wozniak-works/Internal-USB-Hub/docs/TPS25983_Design_Calculator_v1.4.xlsm

TPS25983 Design Calculation Tool
Constants Cells | Input/SelectCells | Calculation Cells |  |  | Recommended
Error Cells, Must be Fixed | Calculated, but can be over-ridden by user |  |  |  | Value
Parameter | Description | Value | Units | Tolerance
VIN (nom) | Nominal operating input voltage | 12.00 | V
VIN (max) | Maximum Operating input voltage (magnitude) | 14.40 | V |  | #REF!
OVLOset | Overvoltage Threshold (VIN Rising) | 15.00 | V
UVLOset | Undervoltage Threshold (VIN Rising) | 9.60 | V
VUVP | Internal IN Undervoltage Protection Threshold (VIN Rising) | 2.53 | V | 2.7%
Cout | Load Capacitance | 1000.0 | uF | 10.0%
Rlstart | Load at start-up (assumed to be resistive), Refer to Section 9.2.2.5.2 in Datasheet (http://www.ti.com/lit/ds/symlink/tps25982.pdf) | 24.0 | Ohm |  | 1.0
Imax | Maximum continuous load current (magnitude) | 12.50 | A
Ilimit | Set current Limit 20% (typical) higher than maximum continuous load current | 15.00 | A
TA(max) | Max Ambient Temperature | 70 | degC
 | Do you need to be immue to line transient due to adjacent card “hot-swap events” | No
tITIMER | Enter the time interval to support load transient currents | 2000 | us
 | Fault Response | Auto-Retry
tRETRY_DLY | Time delay between retries | 100.00 | ms
NRETRY | Number of retries | 4
Rec_VIMONMax | Recommended maximum IMON voltage | 3.3 | V
VIMON-Max | Enter current monitor (IMON) full-scale voltage range | 2.0 | V
UVLO, OVLO set point calculations |  |  |  |  |  |  |  |  |  | 960 |  | 71.28571429
UVLO Set Point | Desired Undervoltage Threshold (VIN Rising) | 9.60 |  |  |  |  |  | 8.66 | Power Fail (VIN Falling) | 150
OVLO Set Point | Desired Over Voltage Lockout Set Point | 15.00 |  |  |  |  |  | 9.44 | Release UVLO (VIN Rising)
R1: Pullup at EN/OVLO Pin | Value > 350K recommended | 499.0 | kOhm | 1.0% |  |  |  | 14.74 | OV Cut-off (VIN Rising) | 154
R2_cal | Calculated value of Resistor at EN/OVLO pin | 25.7 | kOhm
R3_cal | Calculated value of Resistor at EN/OVLO pin | 45.6 | kOhm
SELECT THE VALUE OF RESISTORS AS CLOSEST AVAILABLE VALUE OF R2 & R3
R2 | Select the closest possible value as R2_cal | 26.10 | kOhm | 1.00% | 26.1
R3 | Select the closest possible value as R3_cal | 46.53 | kOhm | 1.00% | 46.52906458
UV_final_rising | Undervoltage Threshold (VIN Rising) | 9.44 | V
UV_final_falling | Undervoltage Threshold (VIN Falling) | 8.66 | V
OV_final_rising | Overvoltage Threshold (VIN Rising) | 14.74 | V
OV_final_falling | Overvoltage Threshold (VIN Falling) | 13.51 | V
I_R123 | Current in R1, R2 and R3 Branch | 25.19 | uA
Calculations for Ilimit (resistor on ILIM Pin) |  |  |  |  |  |  |  | 0.56 | Inrush Charging Current | 256.6285714
RILIM_Cal | Calculated current limit resistor | 98.05 | Ohm |  |  |  |  | 14.71 | Overload Curr Limit | 261
SELECT A ILIMIT RESISTOR WITH THE CLOSEST AVAILABLE VALUE OF Rilim_Cal |  |  |  |  |  |  |  |  |  | 980.5238415
RILIM | Select the closest available value of RILIM_cal | 100 | Ohm | 1.0% | 100 |  |  |  |  | 1000
Ilimit_final | Final current Limit Set Point | 14.71 | A | 8.2% | 13.52 | A
Calculations for CURRENT MONITOR |  |  |  |  |  |  |  |  |  | 559.5141179
RIMON_max | Maximum allowed resistance at IMON pin | 559.51 | Ohm |  | 559.51 |  |  |  |  | 549
RIMON_sel | Resistor value selected at IMON pin | 549.00 | Ohm | 1.0% | 549
VIMON_final | Maximum voltage at IMON for maximum load current | 1.96 | V | 3.2%
The range of voltage output at IMON pin will be from 0V to VMON_imax |  | VIMON is Within Limits
Calculations for SoftStart control (external cap on dVdt pin)
Parameter | Description | Value | Units | Tolerance
Tchg_fastest | When no external capacitor is connected (max. slew rate) | 1.63 | ms | 15.0%
Icharge_fastest | Charging current when charging at fastest possible rate If this current is < Ilimit, no capacitor is required at dVdT pin | 7.35 | A
Tchg_req | The charging time required | 20.00 | ms
Icharge_req | Charging (inrush) current desired in the system | 1.00 | A
Cext_dvdt_cal1 | Calculated value of capacitor at dVdT pin for required Tcharge | 7.67 | nF
Cext_dvdt_cal2 | Calculated value of capacitor at dVdT pin for required Icharge | 4.60 | nF |  | 7.67
SELECT A CAPACITOR WITH THE CLOSEST POSSIBLE VALUE to max(Cext_dvdt_cal1, Cext_dvdt_cal2)
CdVdT_ext | The external capacitor connecetd across dVdT pin | 8.20 | nF | 10.0% | 8.2
Icharge | Charging Current as per dVdT setting | 0.56 | A | 18.0%
Does Device Enter Current Limit during start-up? |  | FALSE |  |  | 527.76
Tchg_dVdT | Charging time set | 21.39 | ms | 18.0%
Pd_Cout_startup | Power dissipation due to load cap at start-up | 3.37 | W
Total Power dissipation at Start-up
Pd_Rlstart | Power dissipation due to load resistance at start-up | 1.00 | W
Pd_startup | Total power dissipation at start-up | 4.37 | W |  |  |  |  |  |  | 9.41 | 9.28
 | Max power dissipation allowed for glitch-free startup for the programmed startup time (20% margin) | 7.53 | W | 20.0% | 9.41 |  |  |  |  | 6.40 | 6.69
 | Will the system have glitch-free startup? Look at Thermal Shutdown Limit Plot Tab | YES
Steady state Voltage drop & Power dissipation
Parameter | Description | Value | Units | Tolerance
Vdrop | Maximum voltage drop across device @ 25 degC | 40.00 | mV
Pdiss_Imax | Steady state power dissipation with Max current @ 25degC | 500.00 | mW
Calculations for Transient Overcurrent Blanking Interval
Citimer_cal | Calculated value of capacitor at ITIMER pin | 4.26 | nF |  | 4.26
Citimer_sel | Capacitor value selected at ITIMER pin | 4.30 | nF | 10.0% | 4.3
tITIMER_final | Time duration for which load transients between Ilimit and 2.1xIlimit are allowed | 2021 | us |  | 569.1734912 | nF
Setting the Auto-Retry Delay and Number of Retries
CRETRY_DLY_cal | Calculated value of capacitor at RETRY_DLY pin | 2.13 | nF |  | 2.13
CRETRY_DLY_sel | Capacitor value selected at RETRY_DLY pin | 2.20 | nF | 10.0% | 2.2
tRETRY_DLY_final | Time delay between retries | 103.21 | ms
CNRETRY_cal | Calculated value of capacitor at NRETRY pin | 2.20 | nF |  | 1.98
CNRETRY_sel | Capacitor value selected at NRETRY pin | 1.8 | nF | 10.0% | 1.8 | 3.266787659
NRETRY_final | Number of retries | 4 |  |  | 3.266787659 | 4
Design Summary
 |  | R1 = | 9.6 | kOhm | Parameter |  | Typical | Units
 |  | R2 = | 26.1 | kOhm | Current limit |  | 14.71 | A
 |  | R3 = | 46.53 | kOhm | Upper UVLO Threshold |  | 9.44 | V
 |  | RG = | 2 | Ohm | Lower UVLO Threshold |  | 8.66 | V
 |  | RILIM = | 100 | Ohm | Output voltage ramp time, TdVdt |  | 21.39 | ms
 |  | RIMON = | 549 | Ohm
 |  | RPG = | 10.00 | kOhm | Transient overcurrent blanking interval (tITIMER) |  | 2021 | us
 |  | CdVdt = | 8.20 | nF
 |  | CITIMER = | 4.3 | nF | Time delay between retries |  | 103.21332 | ms
 |  | CRETRY_DLY = | 2.2 | nF | Number of retries |  | 4
 |  | CNRETRY = | 1.8 | nF
 |  |  |  |  | Overvoltage lockout |  | 14.74 | V
Notes: | 1. Although not mandatory, CIN provides transient suppression at the VIN pin | CIN = | 0.01uF | uF
 | 2. TVS clamp diode D1 from VIN to GND is recommented to clamp the voltage overshoot during device turn-off, e.g. during circuit breaker | COUT = | Optional
 | 3. Schottky diode D2 from VOUT to GND is mandatory to absorb negative spikes | D1 = | SMCJxx
 |  | D2 = | B530C-13-F
Parameters internal to Device
Internal FET Parameters
Parameter | Description | Value | Units | Tolerance
VDSS (max) | FET drain-source voltage rating (maximum) | 30.0 | V
ID(max) | FET drain-source current rating (maximum) | 18.0 | A
Rds(on) | FET maximum Rds(on) at 25degC | 3.20 | mOhm
Rds(on)_max | FET maximum Rds(on) at 125degC | 4.50 | mOhm
Thermal Parameters
Tj(max) | Device maximum junction temperature | 150.0 | C
TA(max) | Maximum ambient temperature of the application | 125.0 | C
RJC(top) | Junction to case (top) Thermal Resistance | 36.7 | C/W
RJA | Junction to ambient thermal resistance | 34.6 | C/W
RJC(bot) | Junction-to-case(bottom) thermal resistance | 1.6 | C/W
Internal References
Uvref_rise | Internal Undervoltage reference (Rising) | 1.20 | V | 2.5%
Uvref_fall | Internal Undervoltage reference (Falling) | 1.10 | V | 2.7%
GainIMON | Current monitor gain | 243.00 | uA/A | 3.0%
Idvdt | dVdt Pin Charging Current | 4.76 | uA | 3.0%
Delay
tD,ON | Device turn ON delay | 3.29 | ms
tGHI | Time taken to reach steady state | 30.17 | ms
