wozniak-works/Internal-USB-Hub/production/Impedance-matching/Screenshot 2026-03-18 173056.png

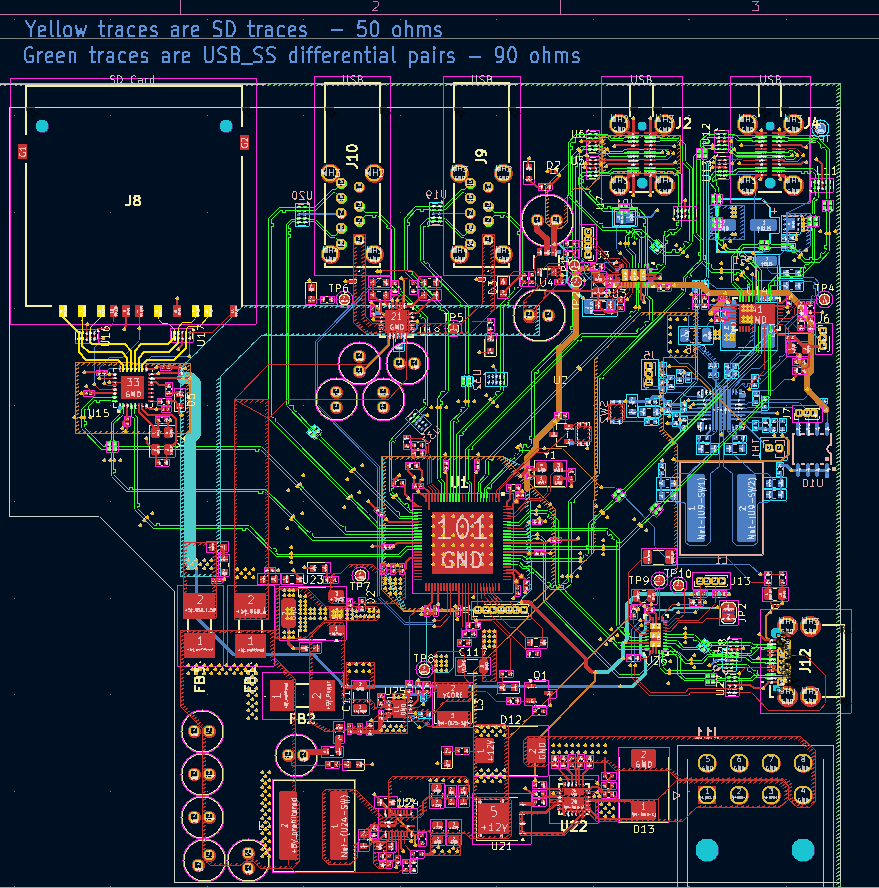
production/Impedance-matching/Screenshot 2026-03-18 173056.png
