wozniak-works/Internal-USB-Hub/production/Impedance-matching/Screenshot 2026-03-18 173109.png

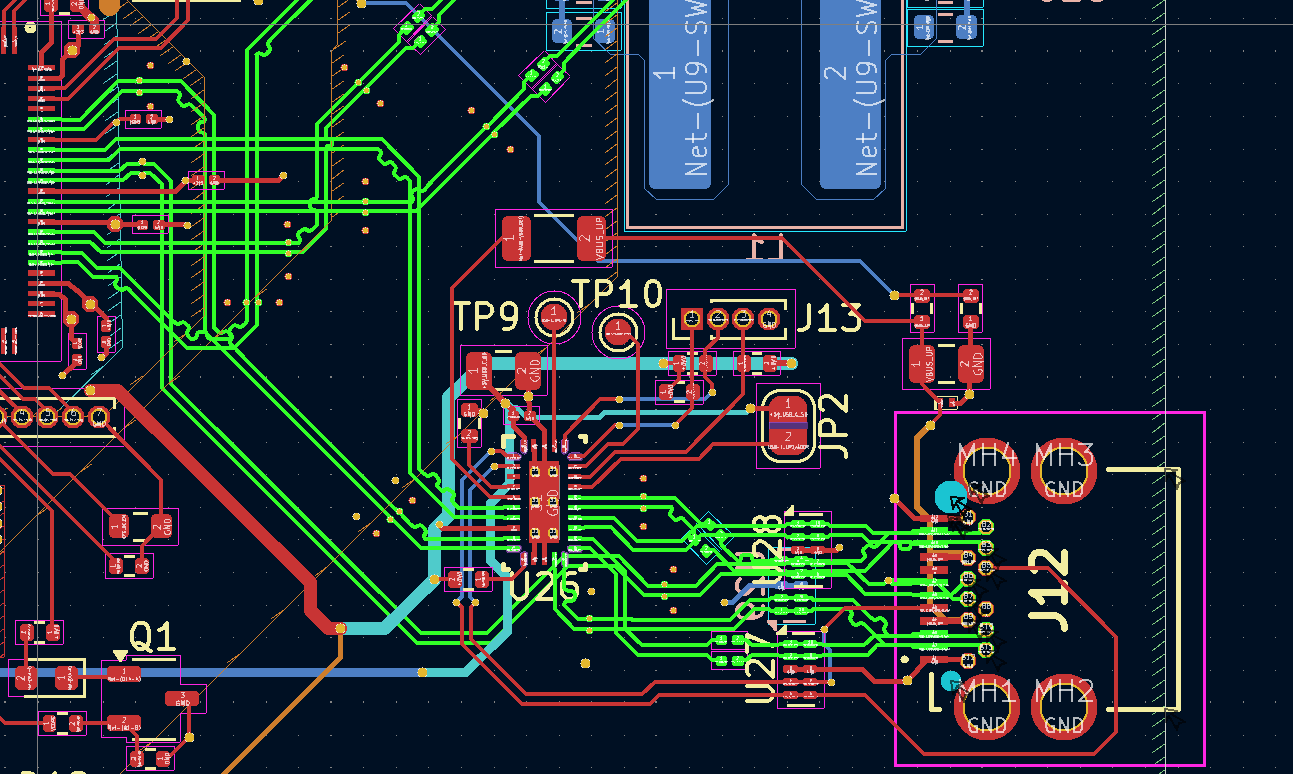
production/Impedance-matching/Screenshot 2026-03-18 173109.png
