wozniak-works/Internal-USB-Hub/footprints/TVS2200DRVR/TVS2200DRVR.step

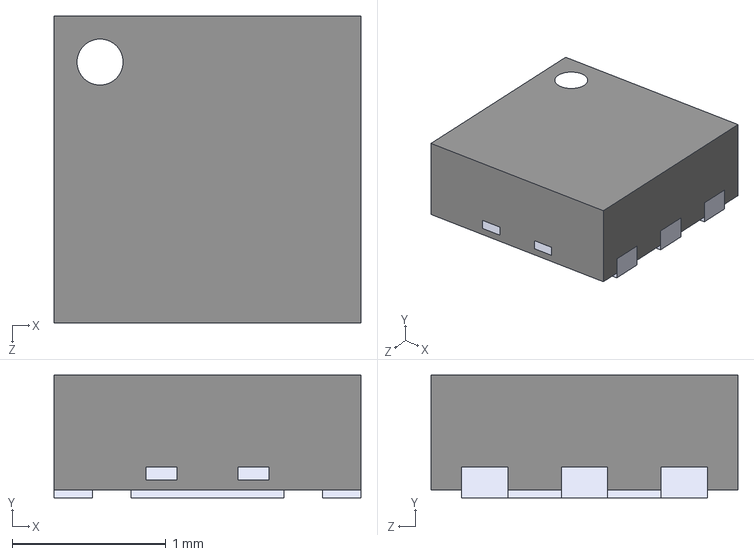
[picture p7: CAD file, 2026-03-18]
footprints/TVS2200DRVR/TVS2200DRVR.step
2.00 x 0.8 x 2.00 mm
