wozniak-works/Internal-USB-Hub/footprints/ul_HD3SS3220IRNHR/RNH0030A.stp

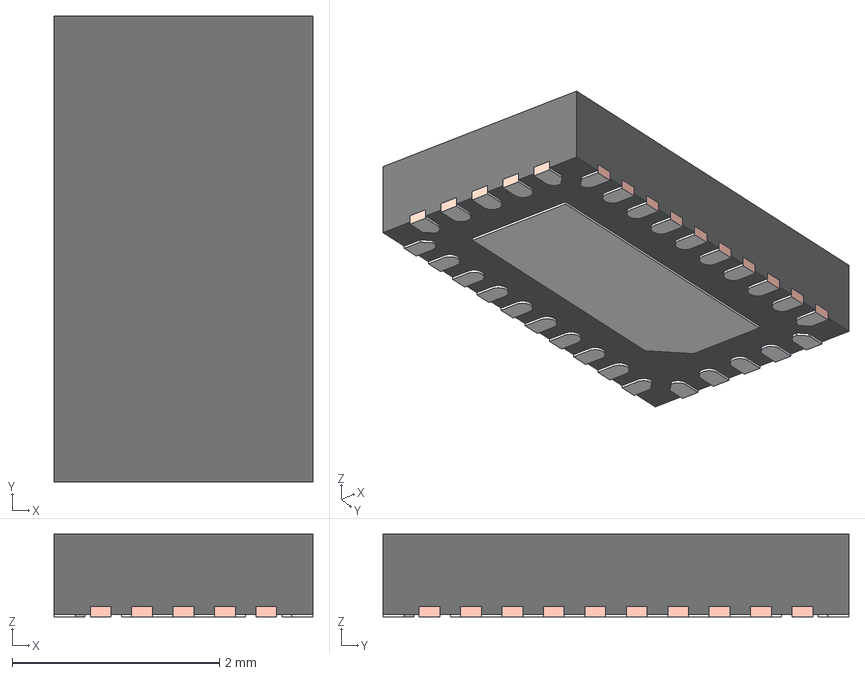
[picture p8: CAD file, 2026-03-18]
footprints/ul_HD3SS3220IRNHR/RNH0030A.stp
2.50 x 4.50 x 0.8 mm
BODY-QFN
FRAME-RNH0030A
PIN1-ID
