wozniak-works/Internal-USB-Hub/footprints/ul_TUSB1146IRNQR/RNQ0040A.stp

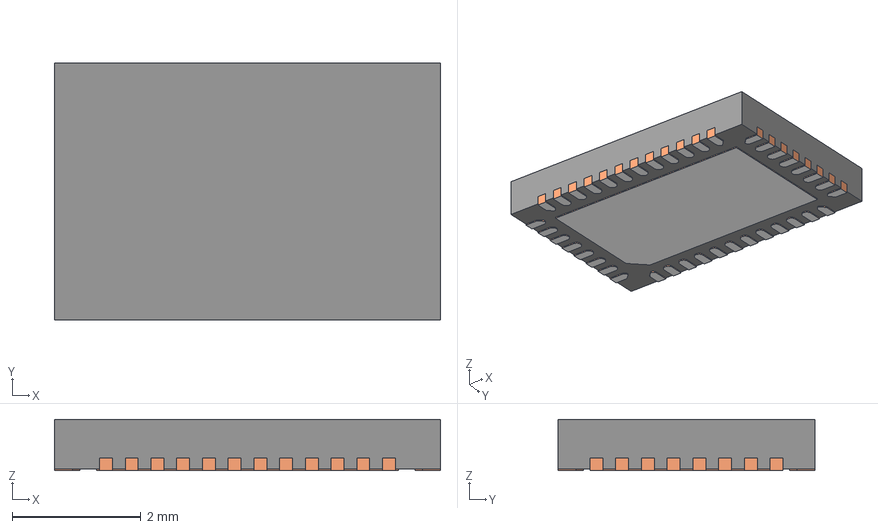
[picture p9: CAD file, 2026-03-18]
footprints/ul_TUSB1146IRNQR/RNQ0040A.stp
6.00 x 4.00 x 0.8 mm
BODY-QFN
FRAME-RNQ0040A
PIN1-ID
