wozniak-works/Internal-USB-Hub/footprints/ul_USB7206C-KDX/VQFN100_KDX_MCH.step

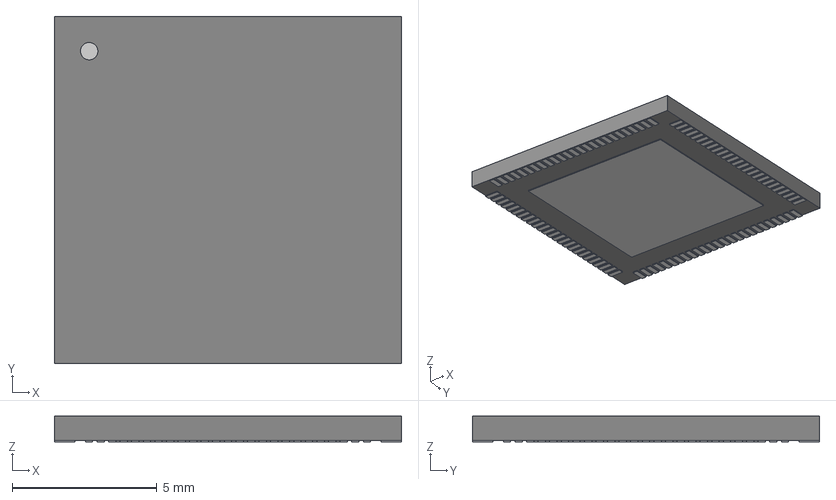
[picture p10: CAD file, 2026-03-18]
footprints/ul_USB7206C-KDX/VQFN100_KDX_MCH.step
12.0 x 12.0 x 0.892 mm
