wozniak-works/Internal-USB-Hub/footprints/TPS25750DRJKR/TPS25750DRJKR.step

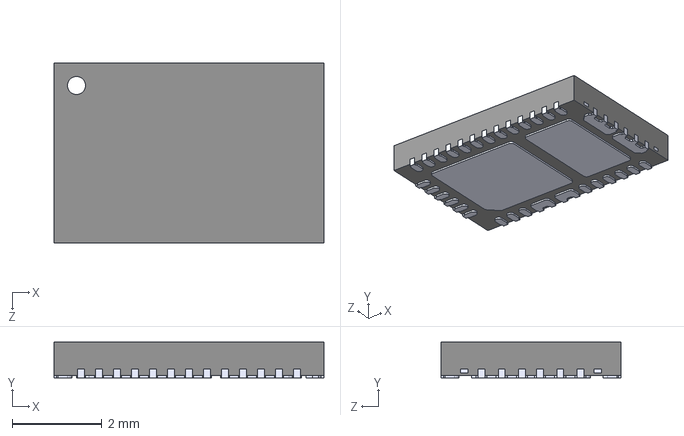
[picture p11: CAD file, 2026-03-18]
footprints/TPS25750DRJKR/TPS25750DRJKR.step
6.00 x 0.8 x 4.00 mm
