wozniak-works/Internal-USB-Hub/(list of files, cad)

Other CAD files:
footprints/ul_HD3SS3220IRNHR/RNH0030A.stl
footprints/ul_TUSB1146IRNQR/RNQ0040A.stl
footprints/ul_USB7206C-KDX/VQFN100_KDX_MCH.stl
