wozniak-works/Internal-USB-Hub/USB_hub.pdf

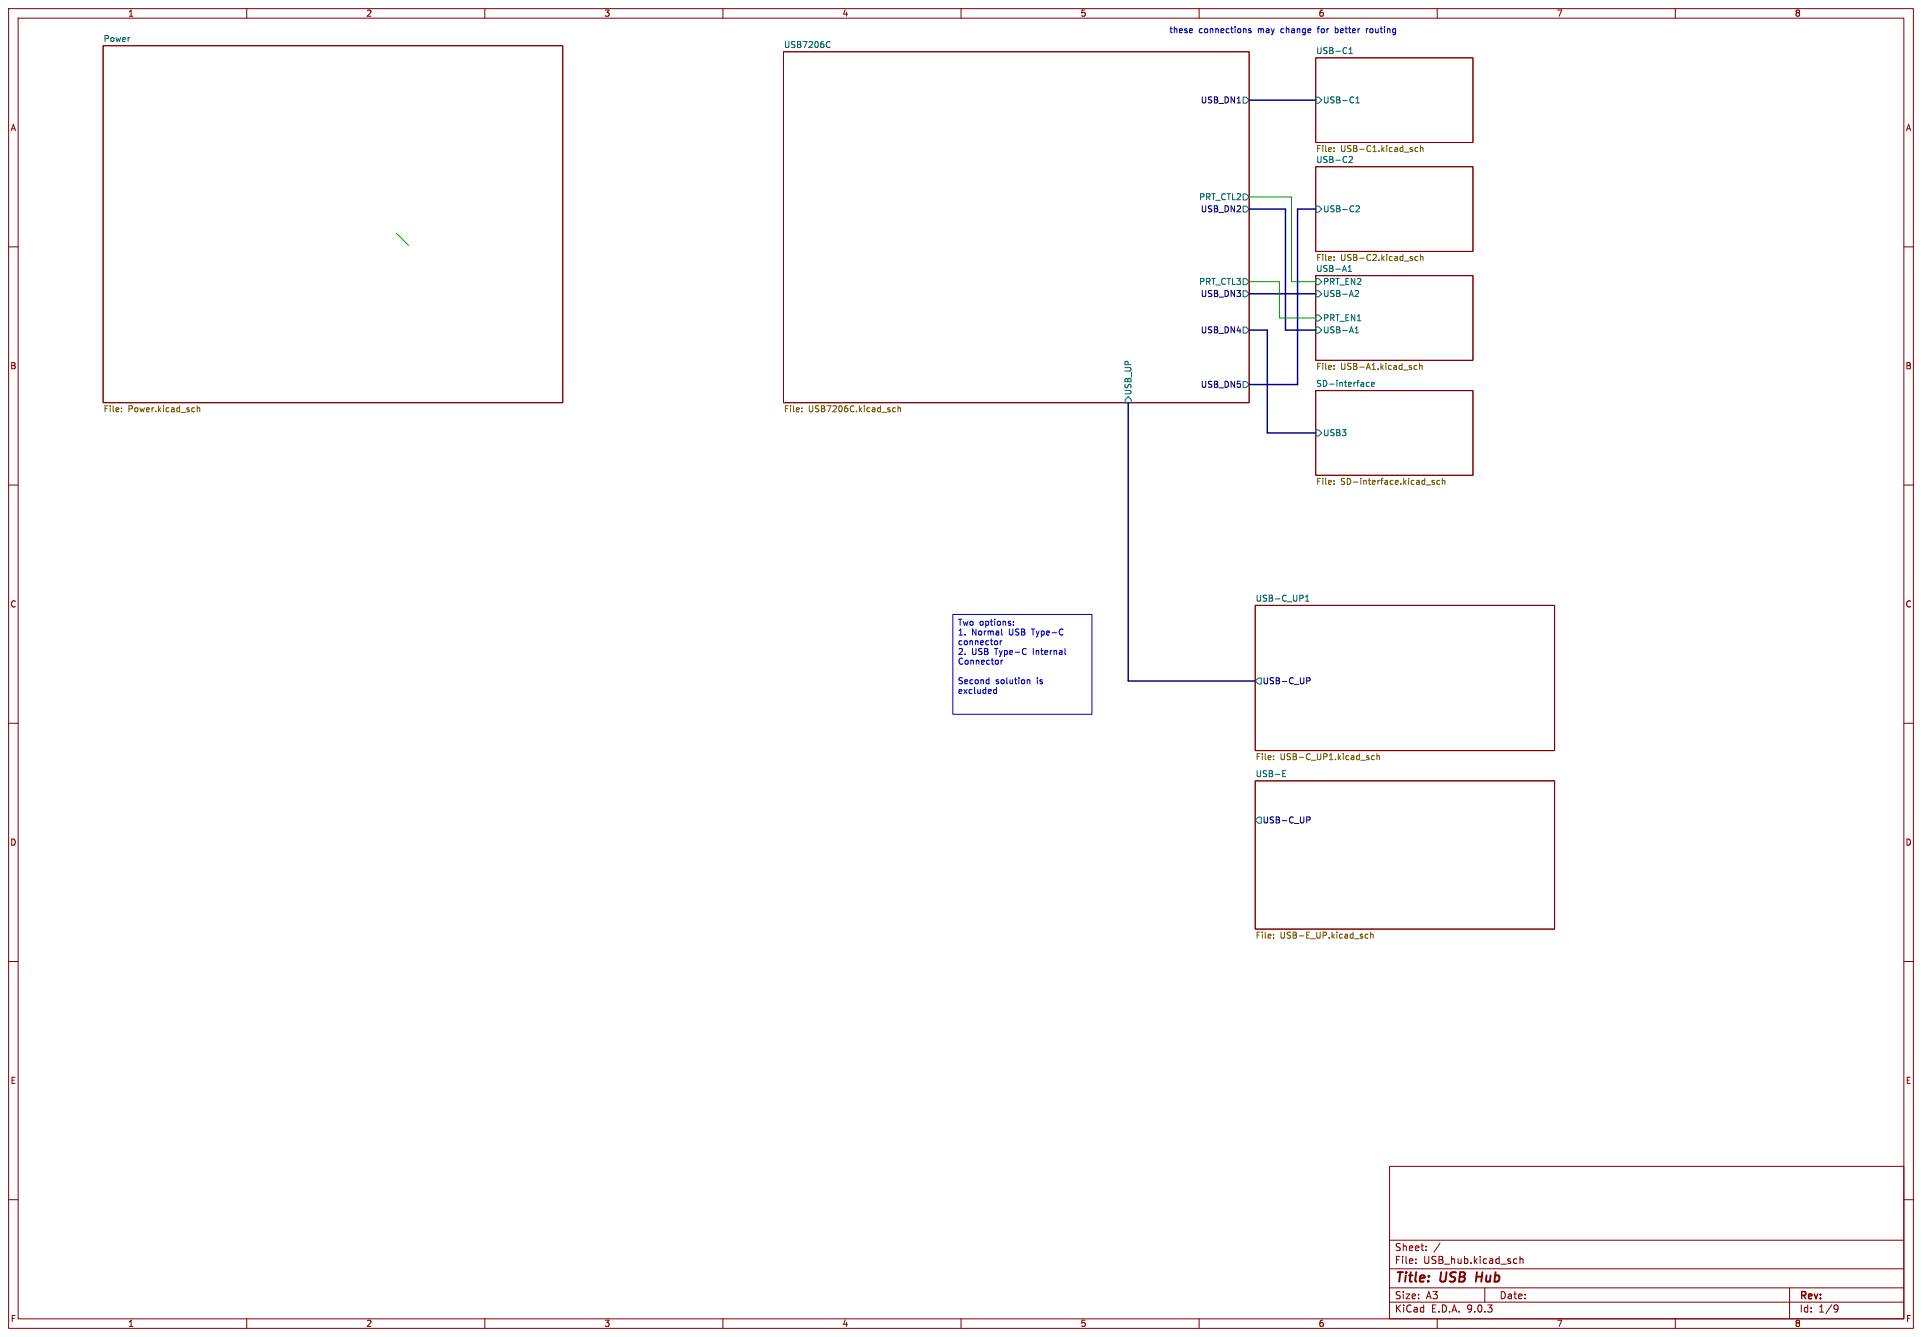
[picture p12: page 1]

File: USB-E_UP.kicad_sch Two options: 1. Normal USB Type-C

File: USB_hub.kicad_sch Sheet: /
Id: 1/9 Title: USB Hub

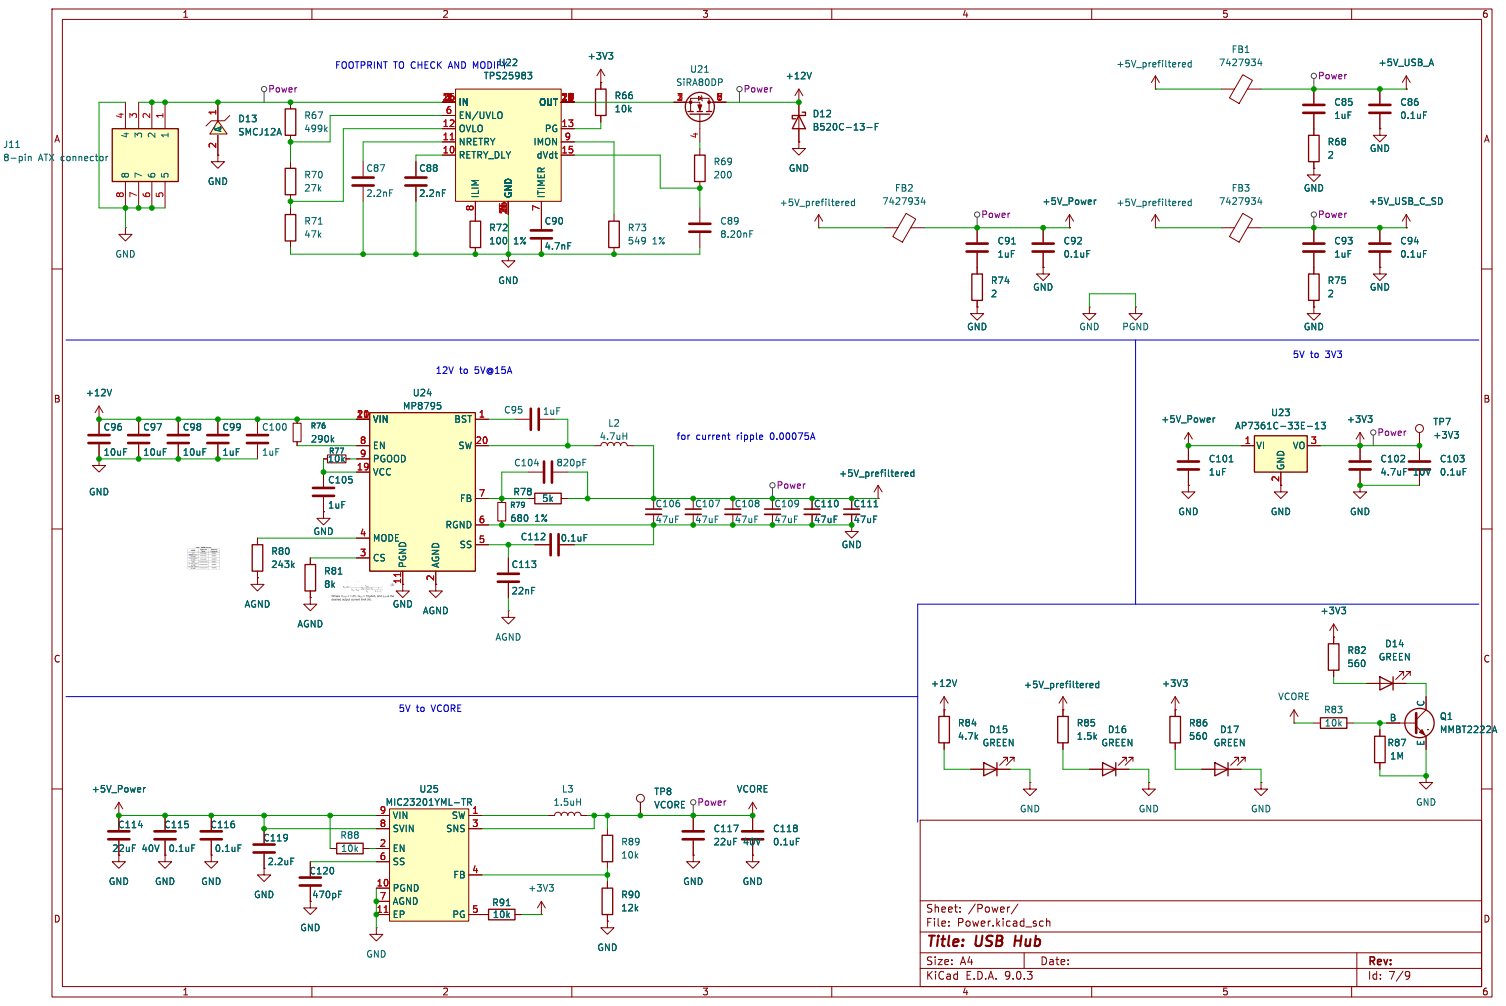
[picture p13: page 2]

FOOTPRINT TO CHECK AND MODIFY

2 BST 1 SW 20 FB 7 RGND 6 SS 5 GND

2 BST 1 SW 20 FB 7 RGND 6 SS 5 U24 MP8795 C113

File: Power.kicad_sch Sheet: /Power/ R91

Id: 7/9 Title: USB Hub

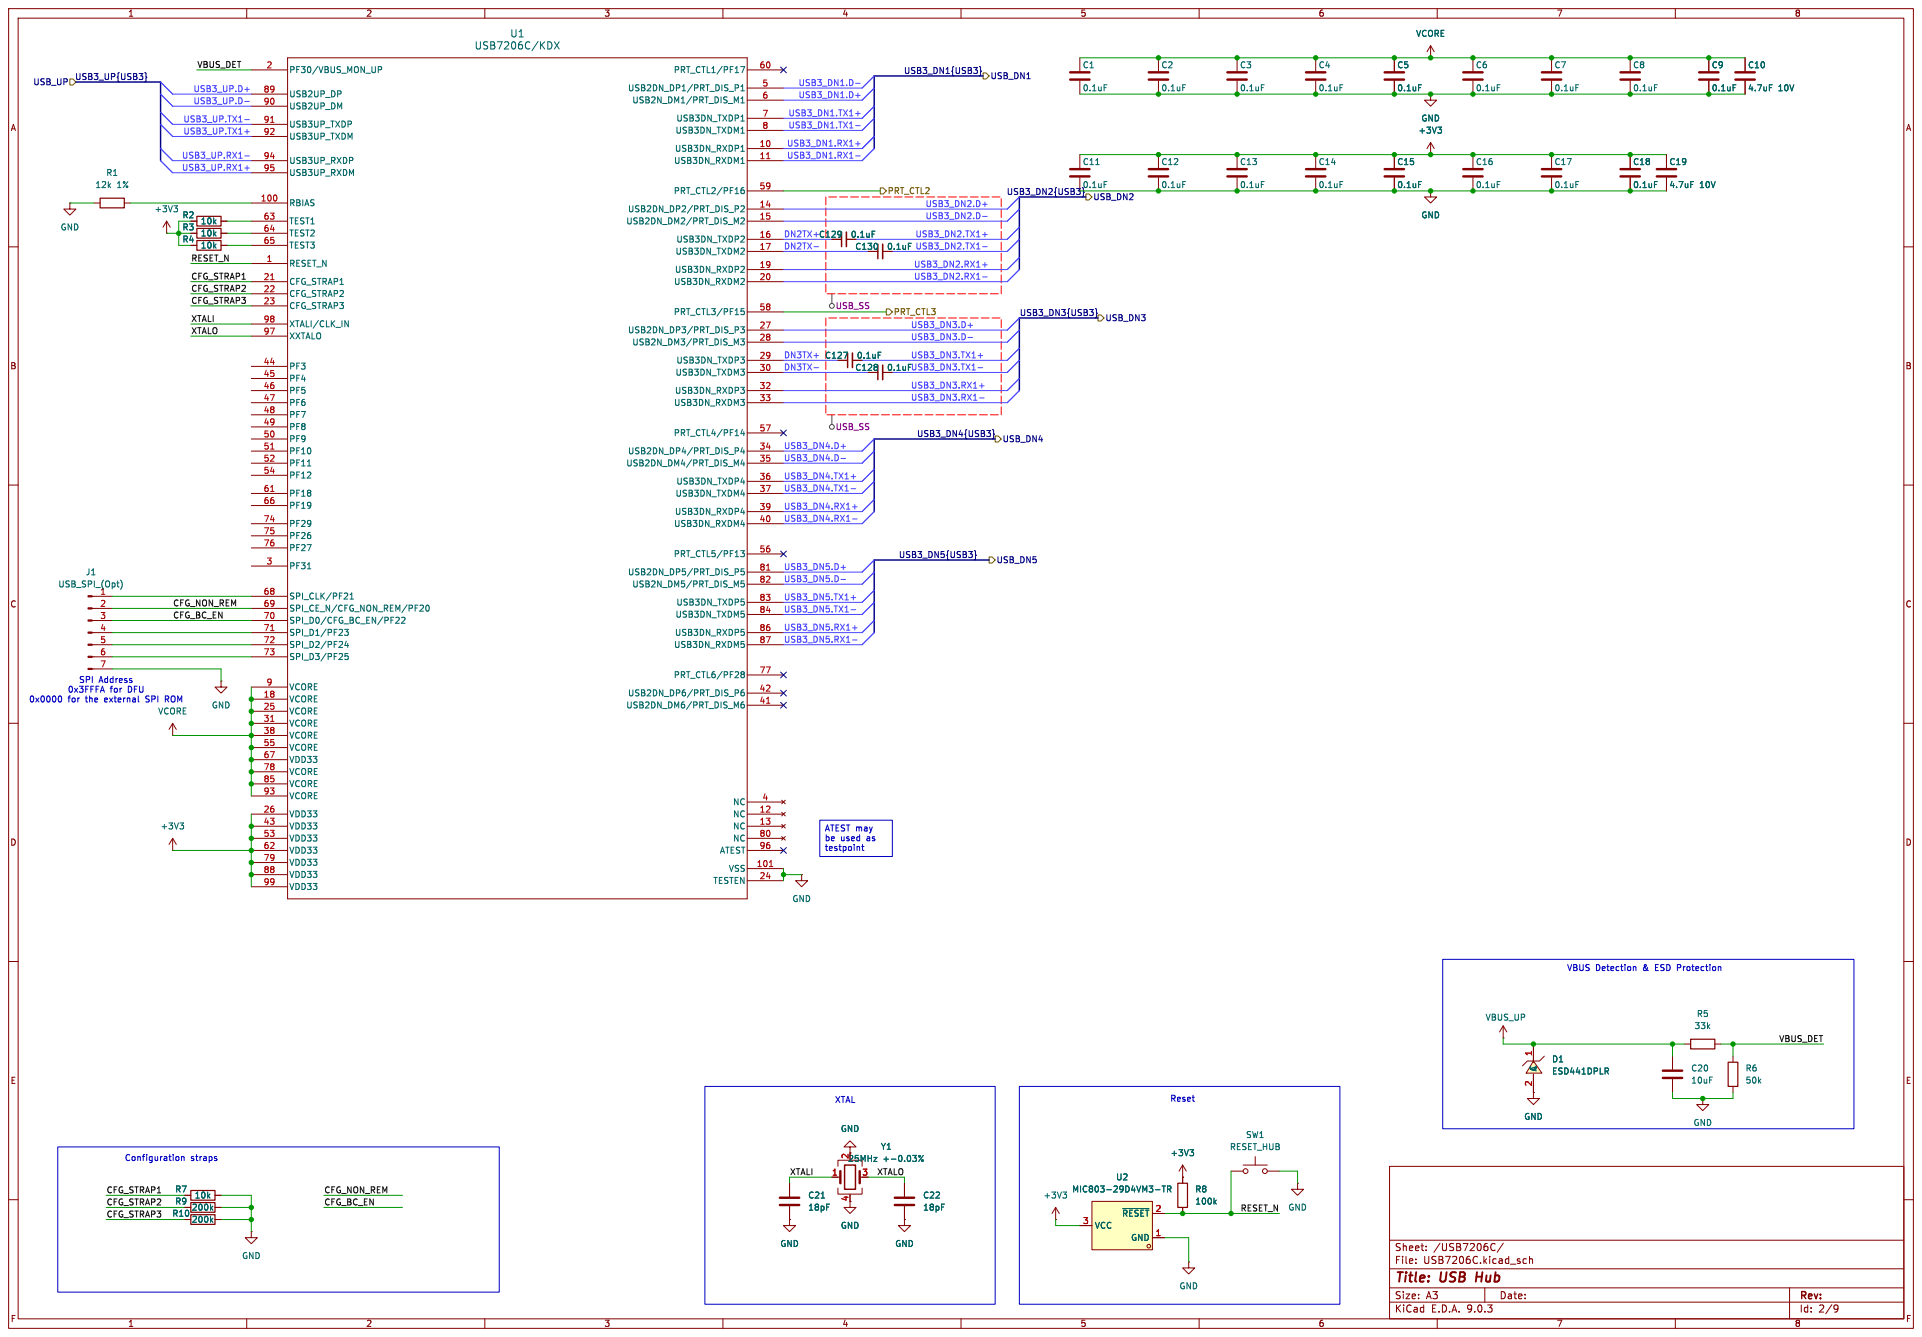
[picture p14: page 3]

ATEST may be used as

Id: 2/9 Title: USB Hub

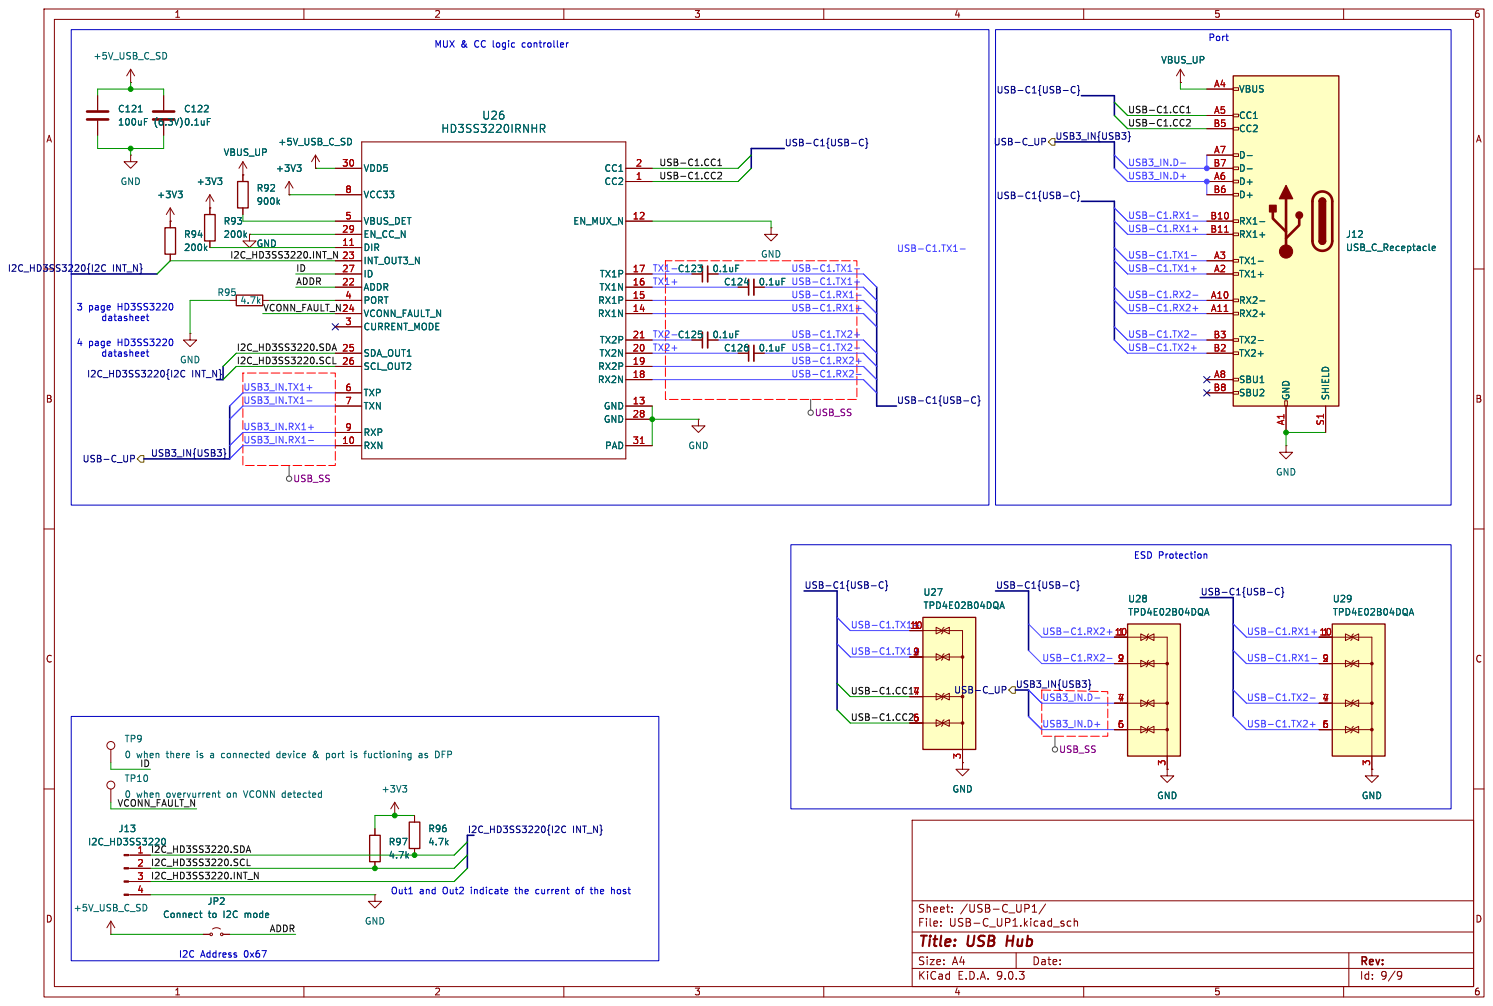
[picture p15: page 4]

Id: 9/9 Title: USB Hub

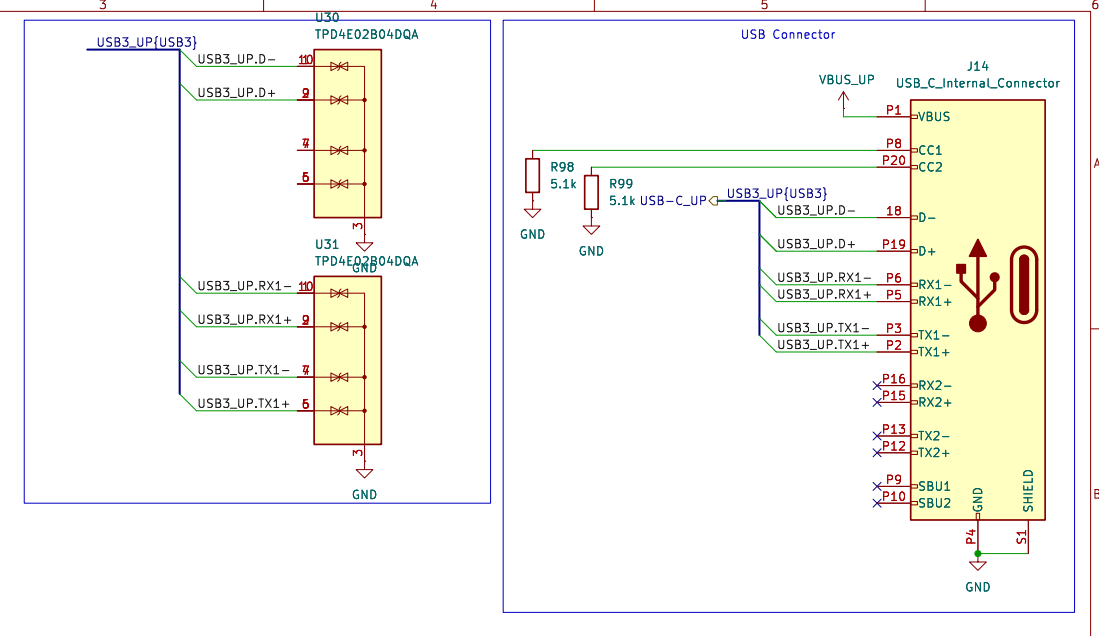
[picture p16: page 5]

File: USB-E_UP.kicad_sch Sheet: /USB-E/
Id: 10/9 Title: USB Hub

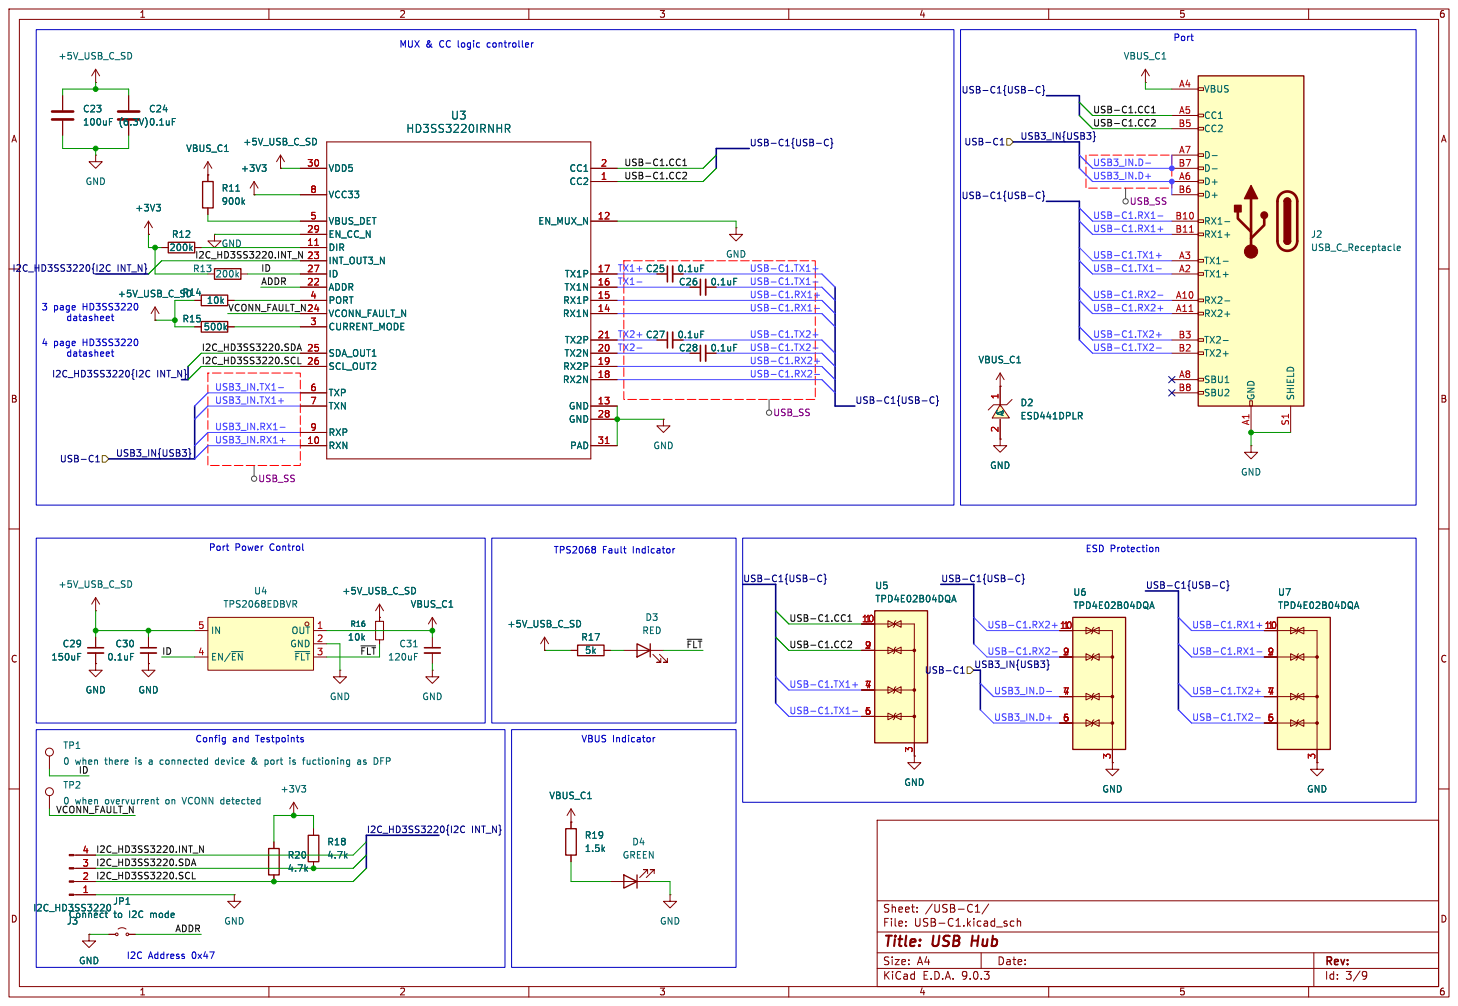
[picture p17: page 6]

USB-C1.CC1 USB-C1.CC2 USB-C1{USB-C}

Id: 3/9 Title: USB Hub

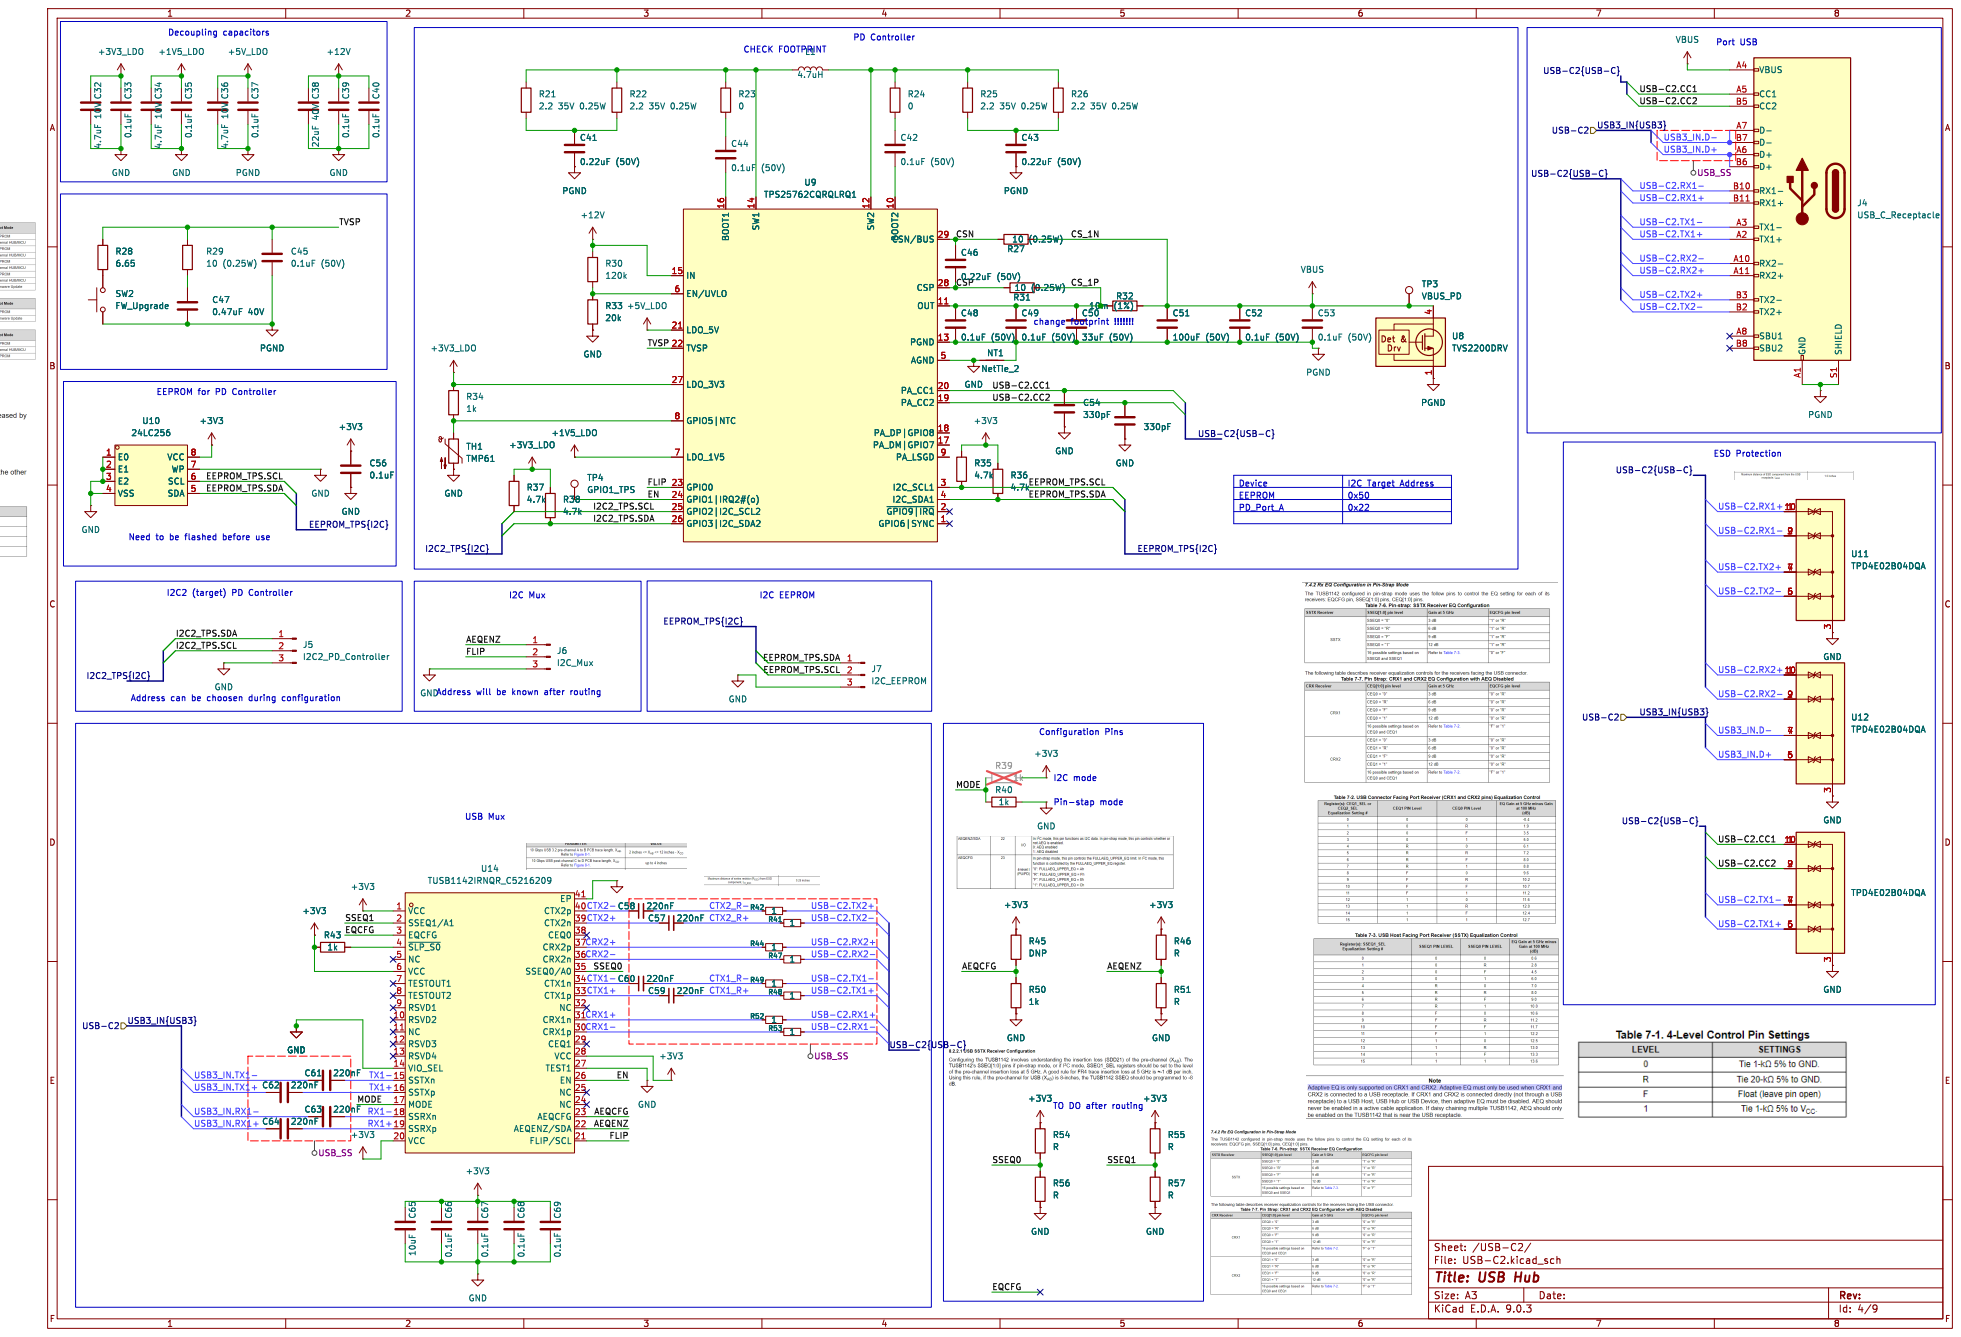
[picture p18: page 7]

CHECK FOOTPRINT Need to be flashed before use

VBUS
PGND SHIELD S1 GND A1 VBUS

USB-C2.TX1- USB-C2.RX2+ USB-C2.RX2- USB-C2.TX1+

Address can be choosen during configuration

File: USB-C2.kicad_sch Sheet: /USB-C2/ R57 R

Id: 4/9 Title: USB Hub

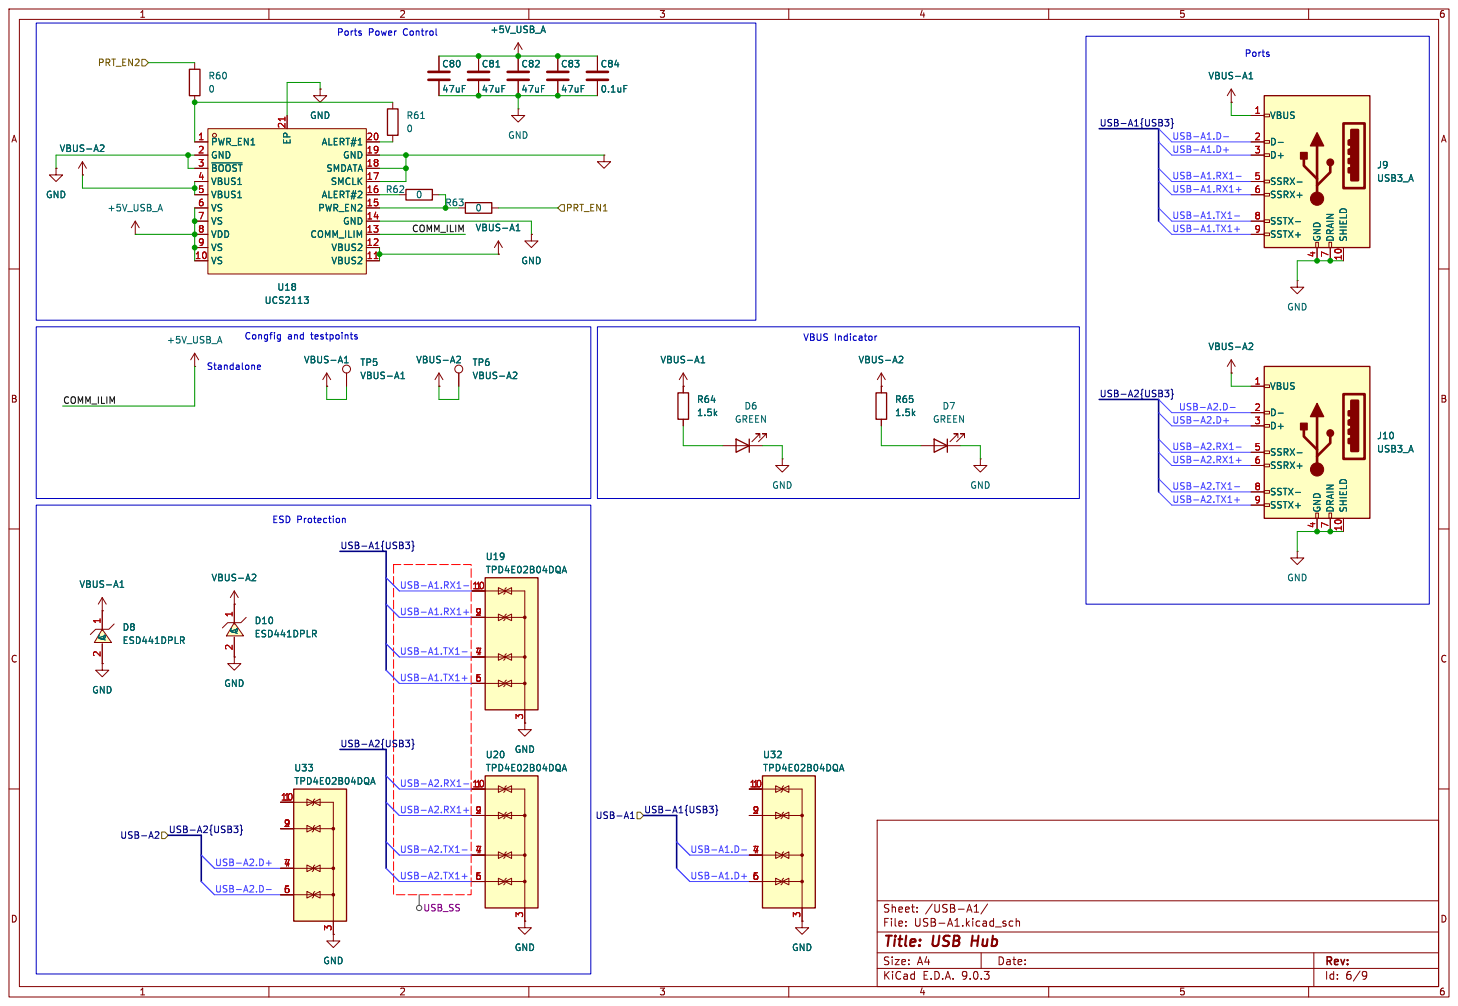
[picture p19: page 8]

4 VBUS 1 D- 2 D+ 3 SSRX- 5 SSRX+ 6 SSTX- 8 SSTX+ 9

4 VBUS 1 D- 2 D+ 3 SSRX- 5 SSRX+ 6 SSTX- 8 SSTX+ 9 VBUS-A2 TP6 VBUS-A2 TP5 VBUS-A2 VBUS-A1 VBUS-A1R64

File: USB-A1.kicad_sch Sheet: /USB-A1/GND

Id: 6/9 Title: USB Hub

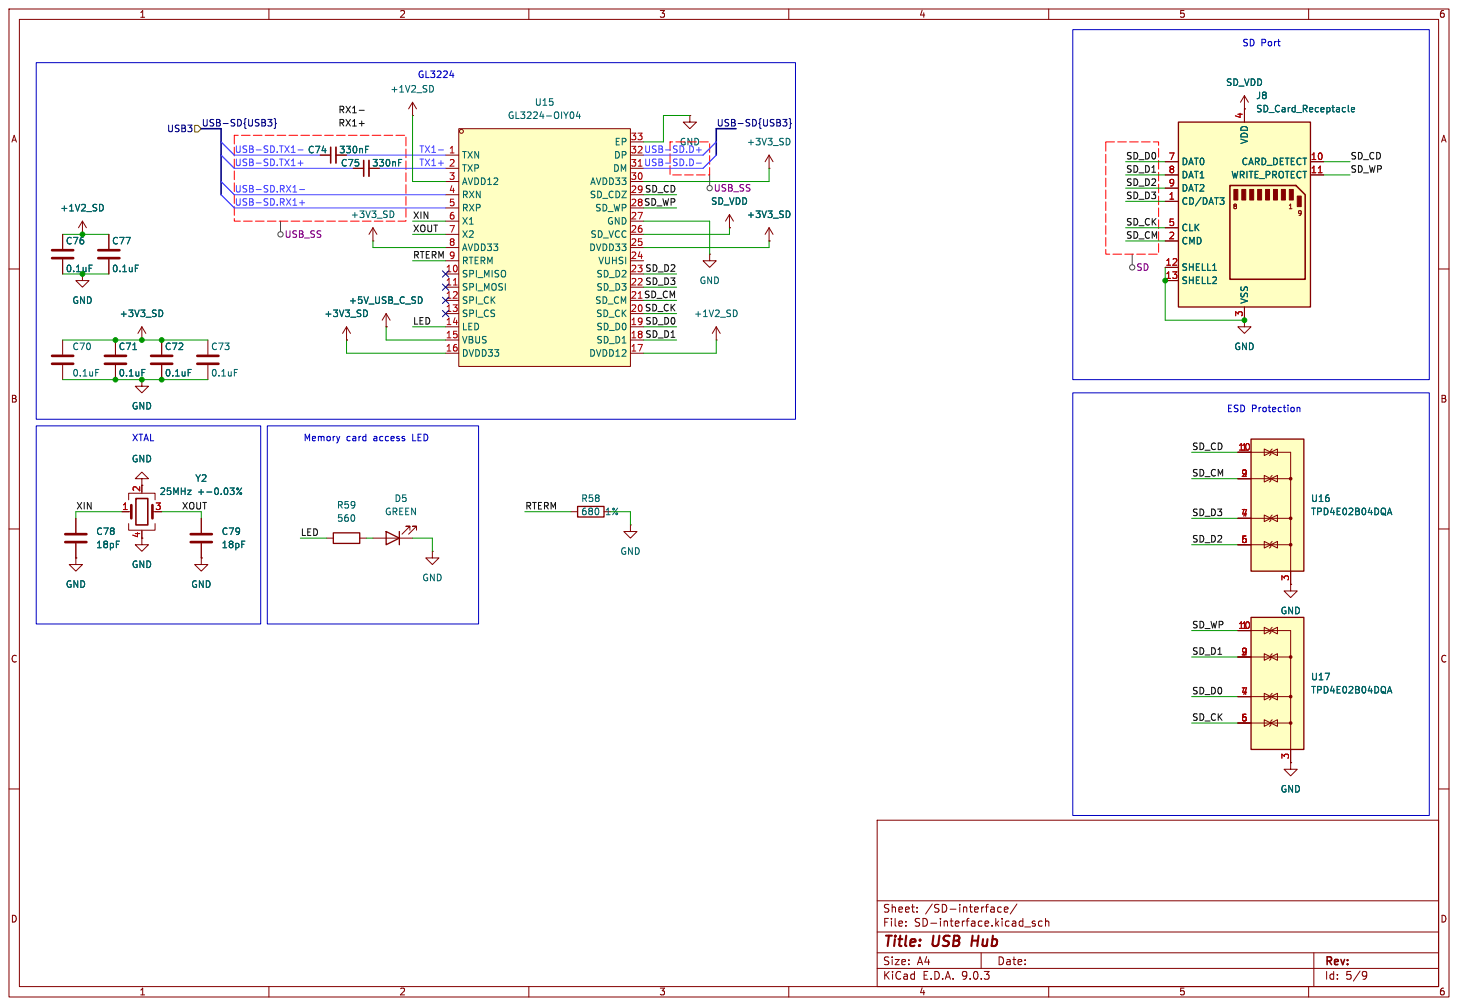
[picture p20: page 9]

SD_D1 SD_D2 SD_CK USB-SD.D+ USB-SD.D- SD_WP

File: SD-interface.kicad_sch Sheet: /SD-interface/
Id: 5/9 Title: USB Hub
