wozniak-works/Internal-USB-Hub/(list of files, drawings)

Other design files:
docs/application notes/3p3V_SAM9X6_SDRAM_MIC23201-Altium/MIC23201 Atmel Support.PrjPcb
docs/application notes/3p3V_SAM9X6_SDRAM_MIC23201-Altium/SCH/B_Microchip.SchDoc
