wozniak-works/Internal-USB-Hub/USB_hub.kicad_pcb

## KiCad design USB_hub.kicad_pcb (2026-03-18)

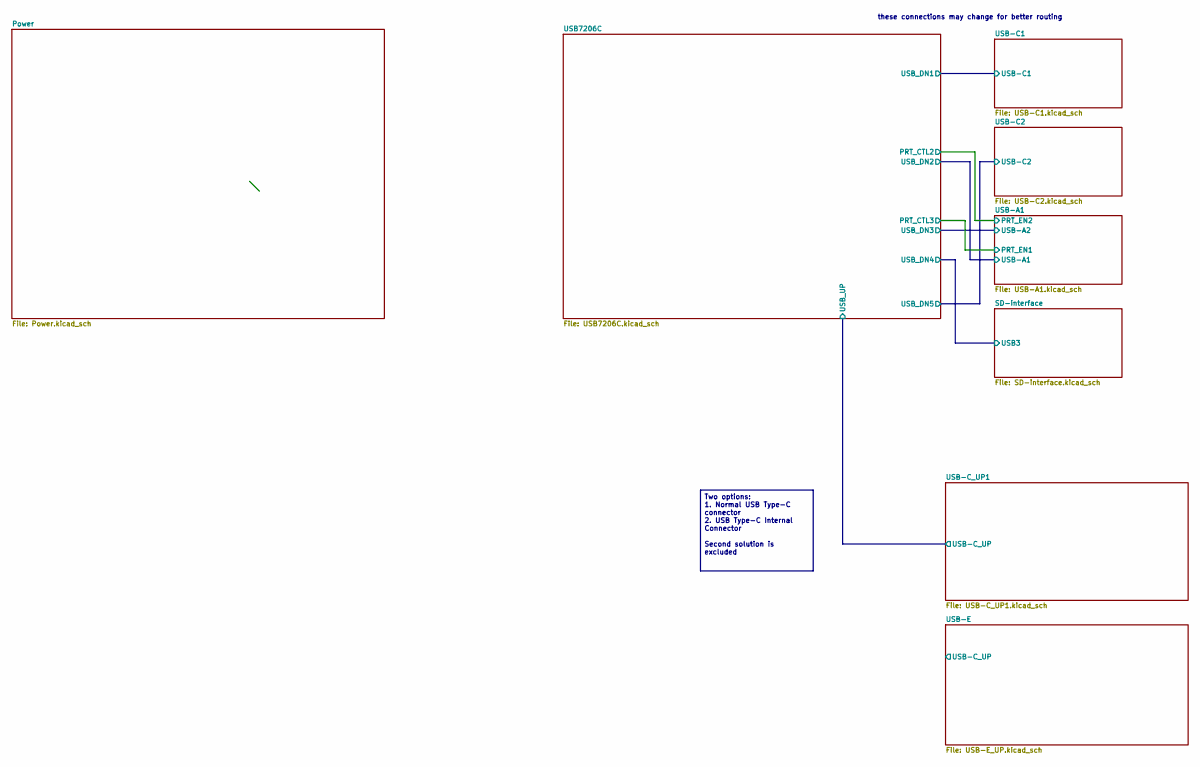
[picture p21: schematic USB_hub.kicad_sch, USB Hub]

Notes on the sheet:
these connections may change for better routing
Two options: 1. Normal USB Type-C connector 2. USB Type-C Internal Connector Second solution is excluded

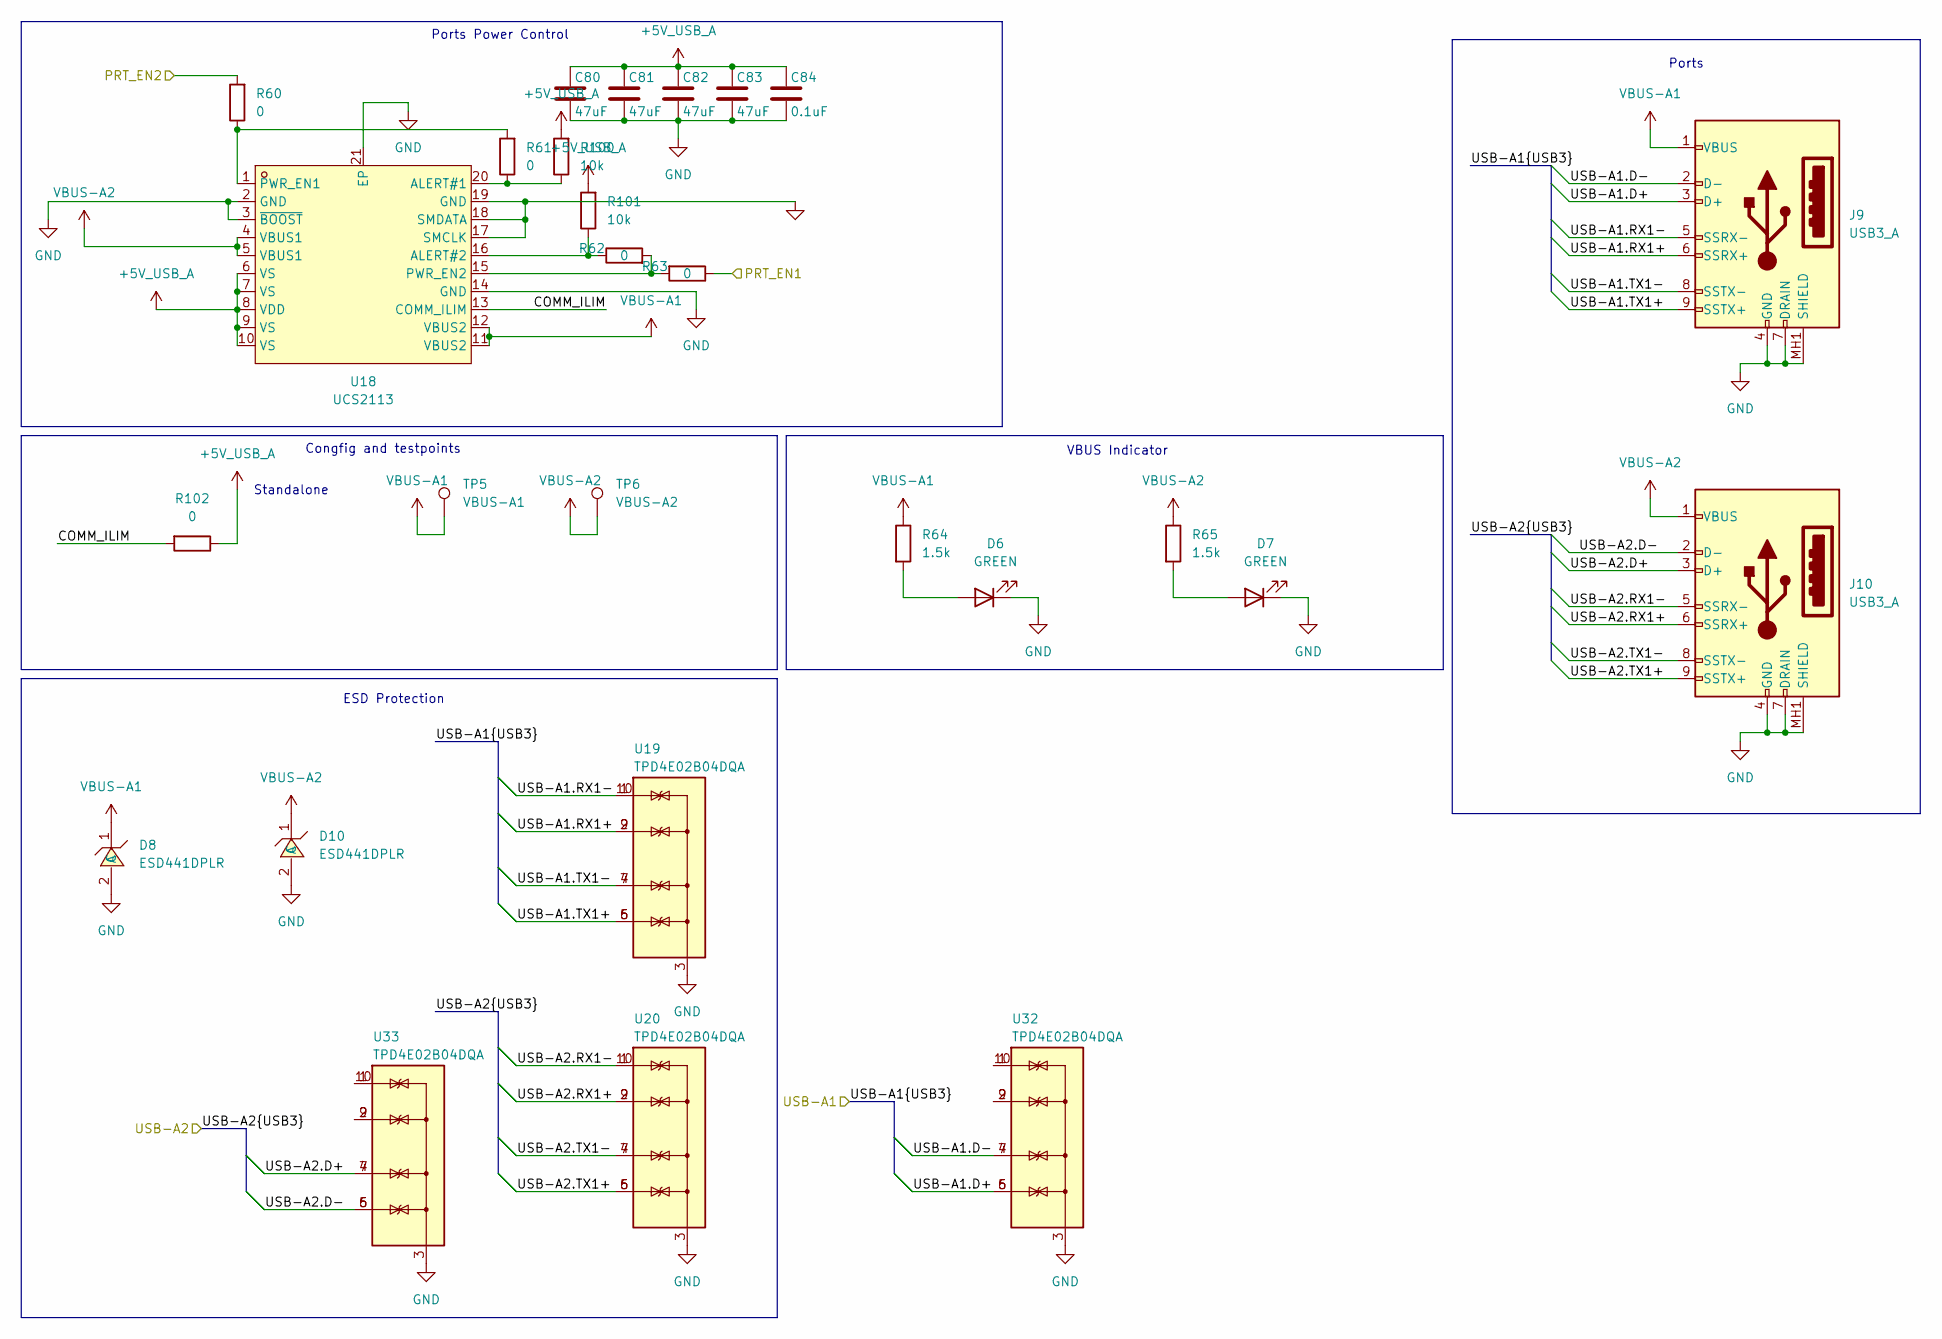
[picture p22: schematic USB-A1.kicad_sch, USB Hub]

Parts:
C80, C81, C82, C83: 47uF; C_Radial_D5.0mm_H11.0mm_P2.00mm; LCSC Part C721300
C84: 0.1uF; C_0201_0603Metric; LCSC Part C181043
D6, D7: GREEN; LED_0603_1608Metric; LCSC Part C22371298
D8, D10: ESD441DPLR; X2SON-2_L0.6-W0.3-P0.35; LCSC Part C22427765
J9, J10: USB3_A; GSB4116344HR; LCSC Part C5429469
R60, R61, R62, R63, R102: 0; R_0603_1608Metric; LCSC Part C2906974
R64, R65: 1.5k; R_0402_1005Metric; LCSC Part C327253
R100, R101: 10k; R_0402_1005Metric; LCSC Part C2906974
TP5: VBUS-A1; TestPoint_Pad_D1.0mm
TP6: VBUS-A2; TestPoint_Pad_D1.0mm
U18: UCS2113; QFN-20_L4.0-W4.0-P0.50-BL-EP2.7; LCSC Part C638222
U19, U20, U32, U33: TPD4E02B04DQA; USON-10_2.5x1.0mm_P0.5mm; LCSC Part C106794

Connections:
+5V_USB_A: C80.1, C81.1, C82.1, C83.1, C84.1, R100.2, R101.2, R102.1, U18.6 (VS), U18.7 (VS), U18.8 (VDD), U18.9 (VS), U18.10 (VS); also elsewhere on the board
/USB-A1/COMM_ILIM: R102.2, U18.13 (COMM_ILIM)
/USB-A1/PRT_EN1: R63.1; also elsewhere on the board
/USB-A1/PRT_EN2: R60.2; also elsewhere on the board
/USB-A1/USB-A1.D+: J9.3 (D+), U32.5 (IO4), U32.6 (NC); also elsewhere on the board
/USB-A1/USB-A1.D-: J9.2 (D-), U32.4 (IO3), U32.7 (NC); also elsewhere on the board
/USB-A1/USB-A1.RX1+: J9.6 (SSRX+), U19.2 (IO2), U19.9 (NC); also elsewhere on the board
/USB-A1/USB-A1.RX1-: J9.5 (SSRX-), U19.1 (IO1), U19.10 (NC); also elsewhere on the board
/USB-A1/USB-A1.TX1+: J9.9 (SSTX+), U19.5 (IO4), U19.6 (NC); also elsewhere on the board
/USB-A1/USB-A1.TX1-: J9.8 (SSTX-), U19.4 (IO3), U19.7 (NC); also elsewhere on the board
/USB-A1/USB-A2.D+: J10.3 (D+), U33.4 (IO3), U33.7 (NC); also elsewhere on the board
/USB-A1/USB-A2.D-: J10.2 (D-), U33.5 (IO4), U33.6 (NC); also elsewhere on the board
/USB-A1/USB-A2.RX1+: J10.6 (SSRX+), U20.2 (IO2), U20.9 (NC); also elsewhere on the board
/USB-A1/USB-A2.RX1-: J10.5 (SSRX-), U20.1 (IO1), U20.10 (NC); also elsewhere on the board
/USB-A1/USB-A2.TX1+: J10.9 (SSTX+), U20.5 (IO4), U20.6 (NC); also elsewhere on the board
/USB-A1/USB-A2.TX1-: J10.8 (SSTX-), U20.4 (IO3), U20.7 (NC); also elsewhere on the board
GND: C80.2, C81.2, C82.2, C83.2, C84.2, D6.1 (K), D7.1 (K), D8.2 (A), D10.2 (A), J9.4 (GND), J9.7 (DRAIN), J9.MH1 (SHIELD), J9.MH2 (SHIELD), J9.MH3 (SHIELD), J9.MH4 (SHIELD), J10.4 (GND), J10.7 (DRAIN), J10.MH1 (SHIELD), J10.MH4 (SHIELD), U18.2 (GND), U18.3 (~BOOST), U18.14 (GND), U18.17 (SMCLK), U18.18 (SMDATA), U18.19 (GND), U18.21 (EP), U19.3 (G), U19.8 (G), U20.3 (G), U20.8 (G), U32.3 (G), U32.8 (G), U33.3 (G), U33.8 (G); also elsewhere on the board
unnamed: D6.2 (A), R64.2
unnamed: D7.2 (A), R65.2
unnamed: R61.1, R100.1, U18.20 (ALERT#1)
unnamed: R62.1, R101.1, U18.16 (ALERT#2)
unnamed: R60.1, R61.2, U18.1 (PWR_EN1)
unnamed: R62.2, R63.2, U18.15 (PWR_EN2)
unnamed: U32.1 (IO1), U32.10 (NC)
unnamed: U32.2 (IO2), U32.9 (NC)
unnamed: U33.1 (IO1), U33.10 (NC)
unnamed: U33.2 (IO2), U33.9 (NC)
VBUS-A1: D8.1 (C), J9.1 (VBUS), R64.1, TP5.1, U18.11 (VBUS2), U18.12 (VBUS2)
VBUS-A2: D10.1 (C), J10.1 (VBUS), R65.1, TP6.1, U18.4 (VBUS1), U18.5 (VBUS1)

Notes on the sheet:
ESD Protection
Standalone
Ports
Congfig and testpoints
VBUS Indicator
Ports Power Control

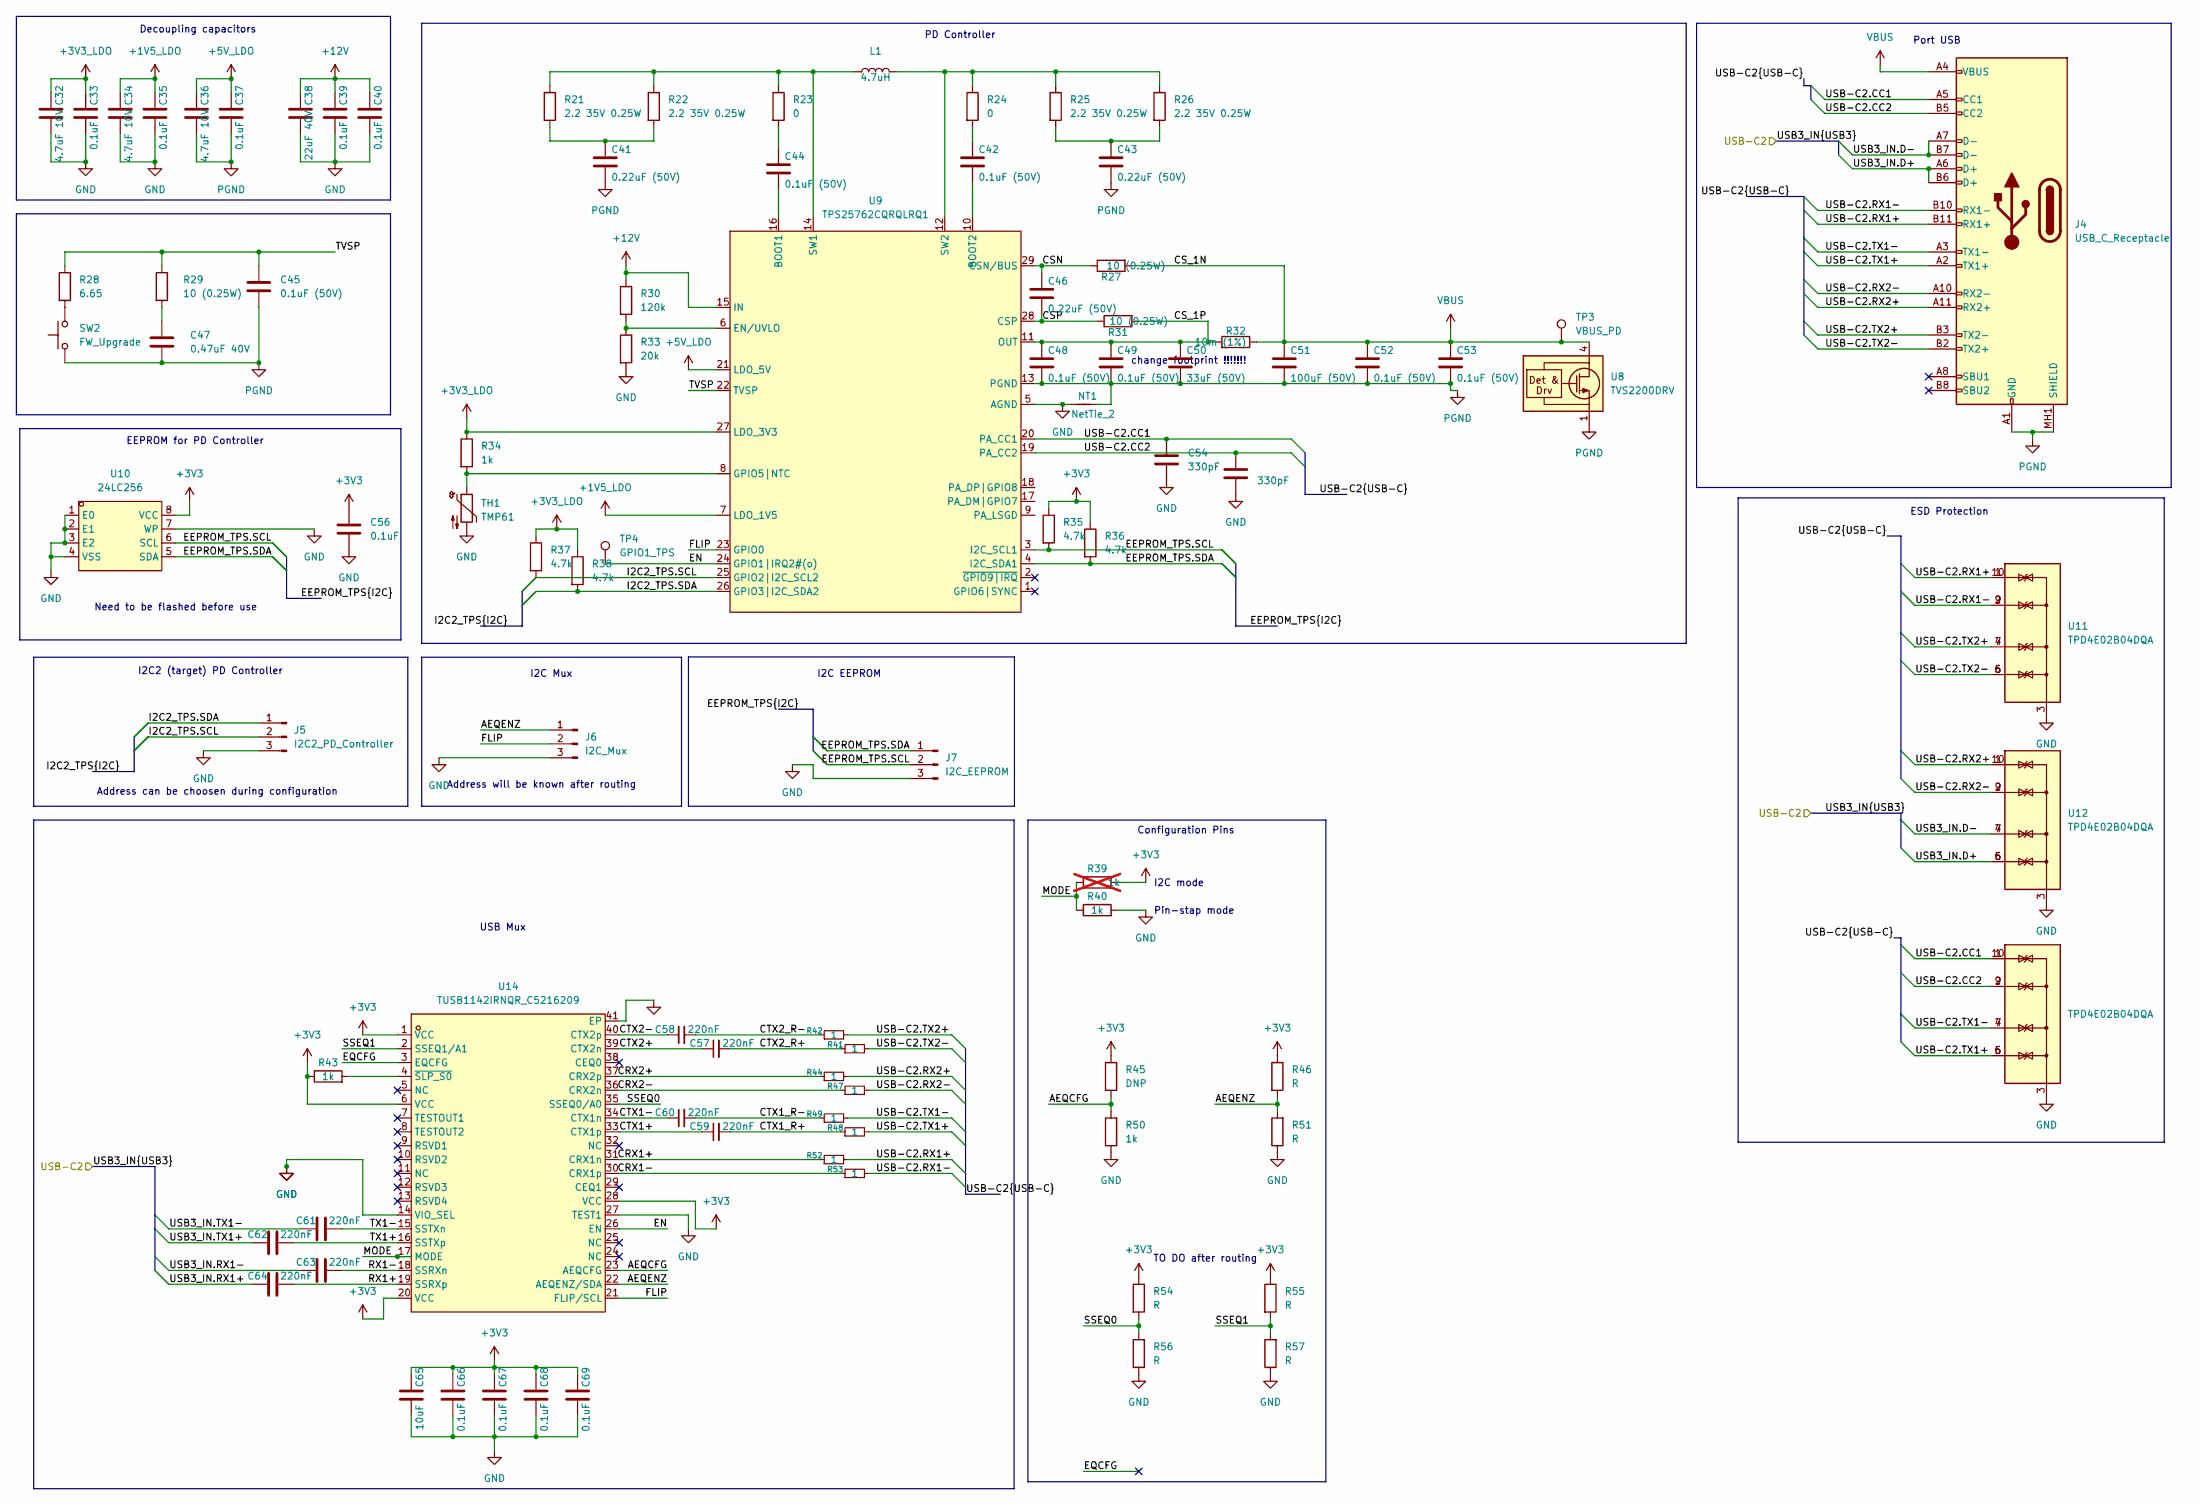
[picture p23: schematic USB-C2.kicad_sch, USB Hub]

Parts:
C32, C34, C36: 4.7uF 10V; C_0402_1005Metric; LCSC Part C318563
C33, C35, C37, C39, C40, C56, C66, C67, C68, C69: 0.1uF; C_0201_0603Metric; LCSC Part C181043
C38: 22uF 40V; C_1206_3216Metric; LCSC Part C309062
C41, C43, C46: 0.22uF (50V); C_0402_1005Metric; LCSC Part C307445
C42, C44, C45, C48, C49, C52, C53: 0.1uF (50V); C_0402_1005Metric; LCSC Part C5182432
C47: 0.47uF 40V; C_0603_1608Metric; LCSC Part C513577
C50: 33uF (50V); C_2220_5750Metric; Mouser Part No 710-865080645010
C51: 100uF (50V); CP_Elec_6.3x7.7; LCSC Part C311622
C54, C55: 330pF; C_0402_1005Metric; LCSC Part C325463
C57, C58, C59, C60, C61, C62, C63, C64: 220nF; C_0201_0603Metric; LCSC Part C701263
C65: 10uF; C_0805_2012Metric; LCSC Part C3039694
J4: USB_C_Receptacle; USB420003A; Mouser Part No 640-USB4200-03-A
J5: I2C2_PD_Controller; PinHeader_1x03_P1.00mm_Vertical
J6: I2C_Mux; PinHeader_1x03_P1.00mm_Vertical
J7: I2C_EEPROM; PinHeader_1x03_P1.00mm_Vertical
L1: 4.7uH; L_Coilcraft_XAL1010-XXX; LCSC Part C18199458
NT1: NetTie_2; R_0603_1608Metric
R21, R22, R25, R26: 2.2 35V 0.25W; R_0603_1608Metric; LCSC Part C966185
R23, R24: 0; R_0603_1608Metric; LCSC Part C2906974
R27, R29, R31: 10 (0.25W); R_0603_1608Metric; LCSC Part C510088
R28: 6.65; R_0402_1005Metric; LCSC Part C407669
R30: 120k; R_0402_1005Metric; LCSC Part C93945
R32: 10m (1%); R_2010_5025Metric; LCSC Part C844898
R33: 20k; R_0402_1005Metric; LCSC Part C25765
R34, R40, R43, R50: 1k; R_0402_1005Metric; LCSC Part C11702
R35, R36, R37, R38: 4.7k; R_0402_1005Metric; LCSC Part C105871
R39: 1k; R_0402_1005Metric; LCSC Part C11702; not fitted
R41, R42, R44, R47, R48, R49, R52, R53: 1; R_0201_0603Metric; LCSC Part C166074
R45: DNP; R_0402_1005Metric
R46, R51, R54, R55, R56, R57: R; R_0402_1005Metric
SW2: FW_Upgrade; ultra_small_switch_1.6x3.0mm; LCSC Part C913788
TH1: TMP61; PinHeader_1x02_P1.27mm_Vertical
TP3: VBUS_PD; TestPoint_Pad_D1.0mm
TP4: GPIO1_TPS; TestPoint_Pad_D1.0mm
U8: TVS2200DRV; WSON-6-1EP_2x2mm_P0.65mm_EP1x1.6mm; LCSC Part C523793
U9: TPS25762CQRQLRQ1; VQFN-HR-29_L6.0-W5.0-P0.50_TPS25762CQRQLRQ1; LCSC Part C5986888
U10: 24LC256; SO-8_L4.9-W3.9-P1.27-LS5.9-BL; LCSC Part C283433
U11, U12, U13: TPD4E02B04DQA; USON-10_2.5x1.0mm_P0.5mm; LCSC Part C106794
U14: TUSB1142IRNQR_C5216209; WQFN-40_L6.0-W4.0-P0.40-TL-EP; LCSC Part C5216209

Connections:
+1V5_LDO: C34.1, C35.1, U9.7 (LDO_1V5)
+3V3: C56.1, C65.1, C66.1, C67.1, C68.1, C69.1, R35.1, R36.1, R39.2, R43.1, R45.1, R46.1, R54.1, R55.1, U10.8 (VCC), U14.1 (VCC), U14.6 (VCC), U14.20 (VCC), U14.28 (VCC); also elsewhere on the board
+3V3_LDO: C32.1, C33.1, R34.1, R37.1, R38.1, U9.27 (LDO_3V3)
+5V_LDO: C36.1, C37.1, U9.21 (LDO_5V)
+12V: C38.1, C39.1, C40.1, R30.1, U9.15 (IN); also elsewhere on the board
/USB-C2/AEQCFG: R45.2, R50.2, U14.23 (AEQCFG)
/USB-C2/AEQENZ: J6.1, R46.2, R51.2, U14.22 (AEQENZ/SDA)
/USB-C2/CRX1+: R52.1, U14.31 (CRX1n)
/USB-C2/CRX1-: R53.1, U14.30 (CRX1p)
/USB-C2/CRX2+: R44.1, U14.37 (CRX2p)
/USB-C2/CRX2-: R47.1, U14.36 (CRX2n)
/USB-C2/CSN: C46.1, R27.1, U9.29 (CSN/BUS)
/USB-C2/CSP: C46.2, R31.1, U9.28 (CSP)
/USB-C2/CS_1P: C48.1, C49.1, C50.1, R31.2, R32.2, U9.11 (OUT)
/USB-C2/CTX1+: C59.1, U14.33 (CTX1p)
/USB-C2/CTX1-: C60.1, U14.34 (CTX1n)
/USB-C2/CTX1_R+: C59.2, R48.1
/USB-C2/CTX1_R-: C60.2, R49.1
/USB-C2/CTX2+: C57.1, U14.39 (CTX2n)
/USB-C2/CTX2-: C58.1, U14.40 (CTX2p)
/USB-C2/CTX2_R+: C57.2, R41.1
/USB-C2/CTX2_R-: C58.2, R42.1
/USB-C2/EEPROM_TPS.SCL: J7.2, R35.2, U9.3 (I2C_SCL1), U10.6 (SCL)
/USB-C2/EEPROM_TPS.SDA: J7.1, R36.2, U9.4 (I2C_SDA1), U10.5 (SDA)
/USB-C2/EN: TP4.1, U9.24 (GPIO1|IRQ2#(o)), U14.26 (EN)
/USB-C2/EQCFG: U14.3 (EQCFG)
/USB-C2/FLIP: J6.2, U9.23 (GPIO0), U14.21 (FLIP/SCL)
/USB-C2/I2C2_TPS.SCL: J5.2, R37.2, U9.25 (GPIO2|I2C_SCL2)
/USB-C2/I2C2_TPS.SDA: J5.1, R38.2, U9.26 (GPIO3|I2C_SDA2)
/USB-C2/MODE: R39.1, R40.1, U14.17 (MODE)
/USB-C2/RX1+: C64.2, U14.19 (SSRXp)
/USB-C2/RX1-: C63.2, U14.18 (SSRXn)
/USB-C2/SSEQ0: R54.2, R56.2, U14.35 (SSEQ0/A0)
/USB-C2/SSEQ1: R55.2, R57.2, U14.2 (SSEQ1/A1)
/USB-C2/TVSP: C45.1, R28.1, R29.1, U9.22 (TVSP)
/USB-C2/TX1+: C62.2, U14.16 (SSTXp)
/USB-C2/TX1-: C61.2, U14.15 (SSTXn)
/USB-C2/USB3_IN.D+: J4.A6 (D+), J4.B6 (D+), U12.5 (IO4), U12.6 (NC); also elsewhere on the board
/USB-C2/USB3_IN.D-: J4.A7 (D-), J4.B7 (D-), U12.4 (IO3), U12.7 (NC); also elsewhere on the board
/USB-C2/USB3_IN.RX1+: C64.1; also elsewhere on the board
/USB-C2/USB3_IN.RX1-: C63.1; also elsewhere on the board
/USB-C2/USB3_IN.TX1+: C62.1; also elsewhere on the board
/USB-C2/USB3_IN.TX1-: C61.1; also elsewhere on the board
/USB-C2/USB-C2.CC1: C54.1, J4.A5 (CC1), U9.20 (PA_CC1), U13.1 (IO1), U13.10 (NC)
/USB-C2/USB-C2.CC2: C55.1, J4.B5 (CC2), U9.19 (PA_CC2), U13.2 (IO2), U13.9 (NC)
/USB-C2/USB-C2.RX1+: J4.B11 (RX1+), R52.2, U11.1 (IO1), U11.10 (NC)
/USB-C2/USB-C2.RX1-: J4.B10 (RX1-), R53.2, U11.2 (IO2), U11.9 (NC)
/USB-C2/USB-C2.RX2+: J4.A11 (RX2+), R44.2, U12.1 (IO1), U12.10 (NC)
/USB-C2/USB-C2.RX2-: J4.A10 (RX2-), R47.2, U12.2 (IO2), U12.9 (NC)
/USB-C2/USB-C2.TX1+: J4.A2 (TX1+), R48.2, U13.5 (IO4), U13.6 (NC)
/USB-C2/USB-C2.TX1-: J4.A3 (TX1-), R49.2, U13.4 (IO3), U13.7 (NC)
/USB-C2/USB-C2.TX2+: J4.B3 (TX2-), R42.2, U11.4 (IO3), U11.7 (NC)
/USB-C2/USB-C2.TX2-: J4.B2 (TX2+), R41.2, U11.5 (IO4), U11.6 (NC)
GND: C32.2, C33.2, C34.2, C35.2, C36.2, C37.2, C38.2, C39.2, C40.2, C41.2, C43.2, C45.2, C47.2, C48.2, C49.2, C50.2, C51.2, C52.2, C53.2, C54.2, C55.2, C56.2, C65.2, C66.2, C67.2, C68.2, C69.2, J4.A1 (GND), J4.A12 (GND), J4.B1 (GND), J4.B12 (GND), J4.MH1 (SHIELD), J4.MH2 (SHIELD), J4.MH3 (SHIELD), J4.MH4 (SHIELD), J5.3, J6.3, J7.3, NT1.1, NT1.2, R33.2, R40.2, R50.1, R51.1, R56.1, R57.1, SW2.1, TH1.2, U8.1 (GND), U8.2 (GND), U8.3 (GND), U8.7 (GND), U9.5 (AGND), U9.13 (PGND), U10.1 (E0), U10.2 (E1), U10.3 (E2), U10.4 (VSS), U10.7 (WP), U11.3 (G), U11.8 (G), U12.3 (G), U12.8 (G), U13.3 (G), U13.8 (G), U14.14 (VIO_SEL), U14.27 (TEST1), U14.41 (EP); also elsewhere on the board
unnamed: C41.1, R21.2, R22.2
unnamed: C42.1, R24.2
unnamed: C43.1, R25.2, R26.2
unnamed: C44.1, R23.2
unnamed: C47.1, R29.2
unnamed: R28.2, SW2.2
unnamed: C44.2, U9.16 (BOOT1)
unnamed: C42.2, U9.10 (BOOT2)
unnamed: R30.2, R33.1, U9.6 (EN/UVLO)
unnamed: R34.2, TH1.1, U9.8 (GPIO5|NTC)
unnamed: L1.1, R21.1, R22.1, R23.1, U9.14 (SW1)
unnamed: L1.2, R24.1, R25.1, R26.1, U9.12 (SW2)
unnamed: R43.2, U14.4 (~SLP_S0)
VBUS: C51.1, C52.1, C53.1, J4.A4 (VBUS), J4.A9 (VBUS), J4.B4 (VBUS), J4.B9 (VBUS), R27.2, R32.1, TP3.1, U8.4 (IN), U8.5 (IN), U8.6 (IN)

Notes on the sheet:
TO DO after routing
I2C2 (target) PD Controller
EEPROM for PD Controller
Address will be known after routing
Address can be choosen during configuration
Configuration Pins
USB Mux
Decoupling capacitors
I2C mode
PD Controller
Pin-stap mode
I2C EEPROM
Port USB
ESD Protection
Need to be flashed before use
I2C Mux
change footprint !!!!!!!

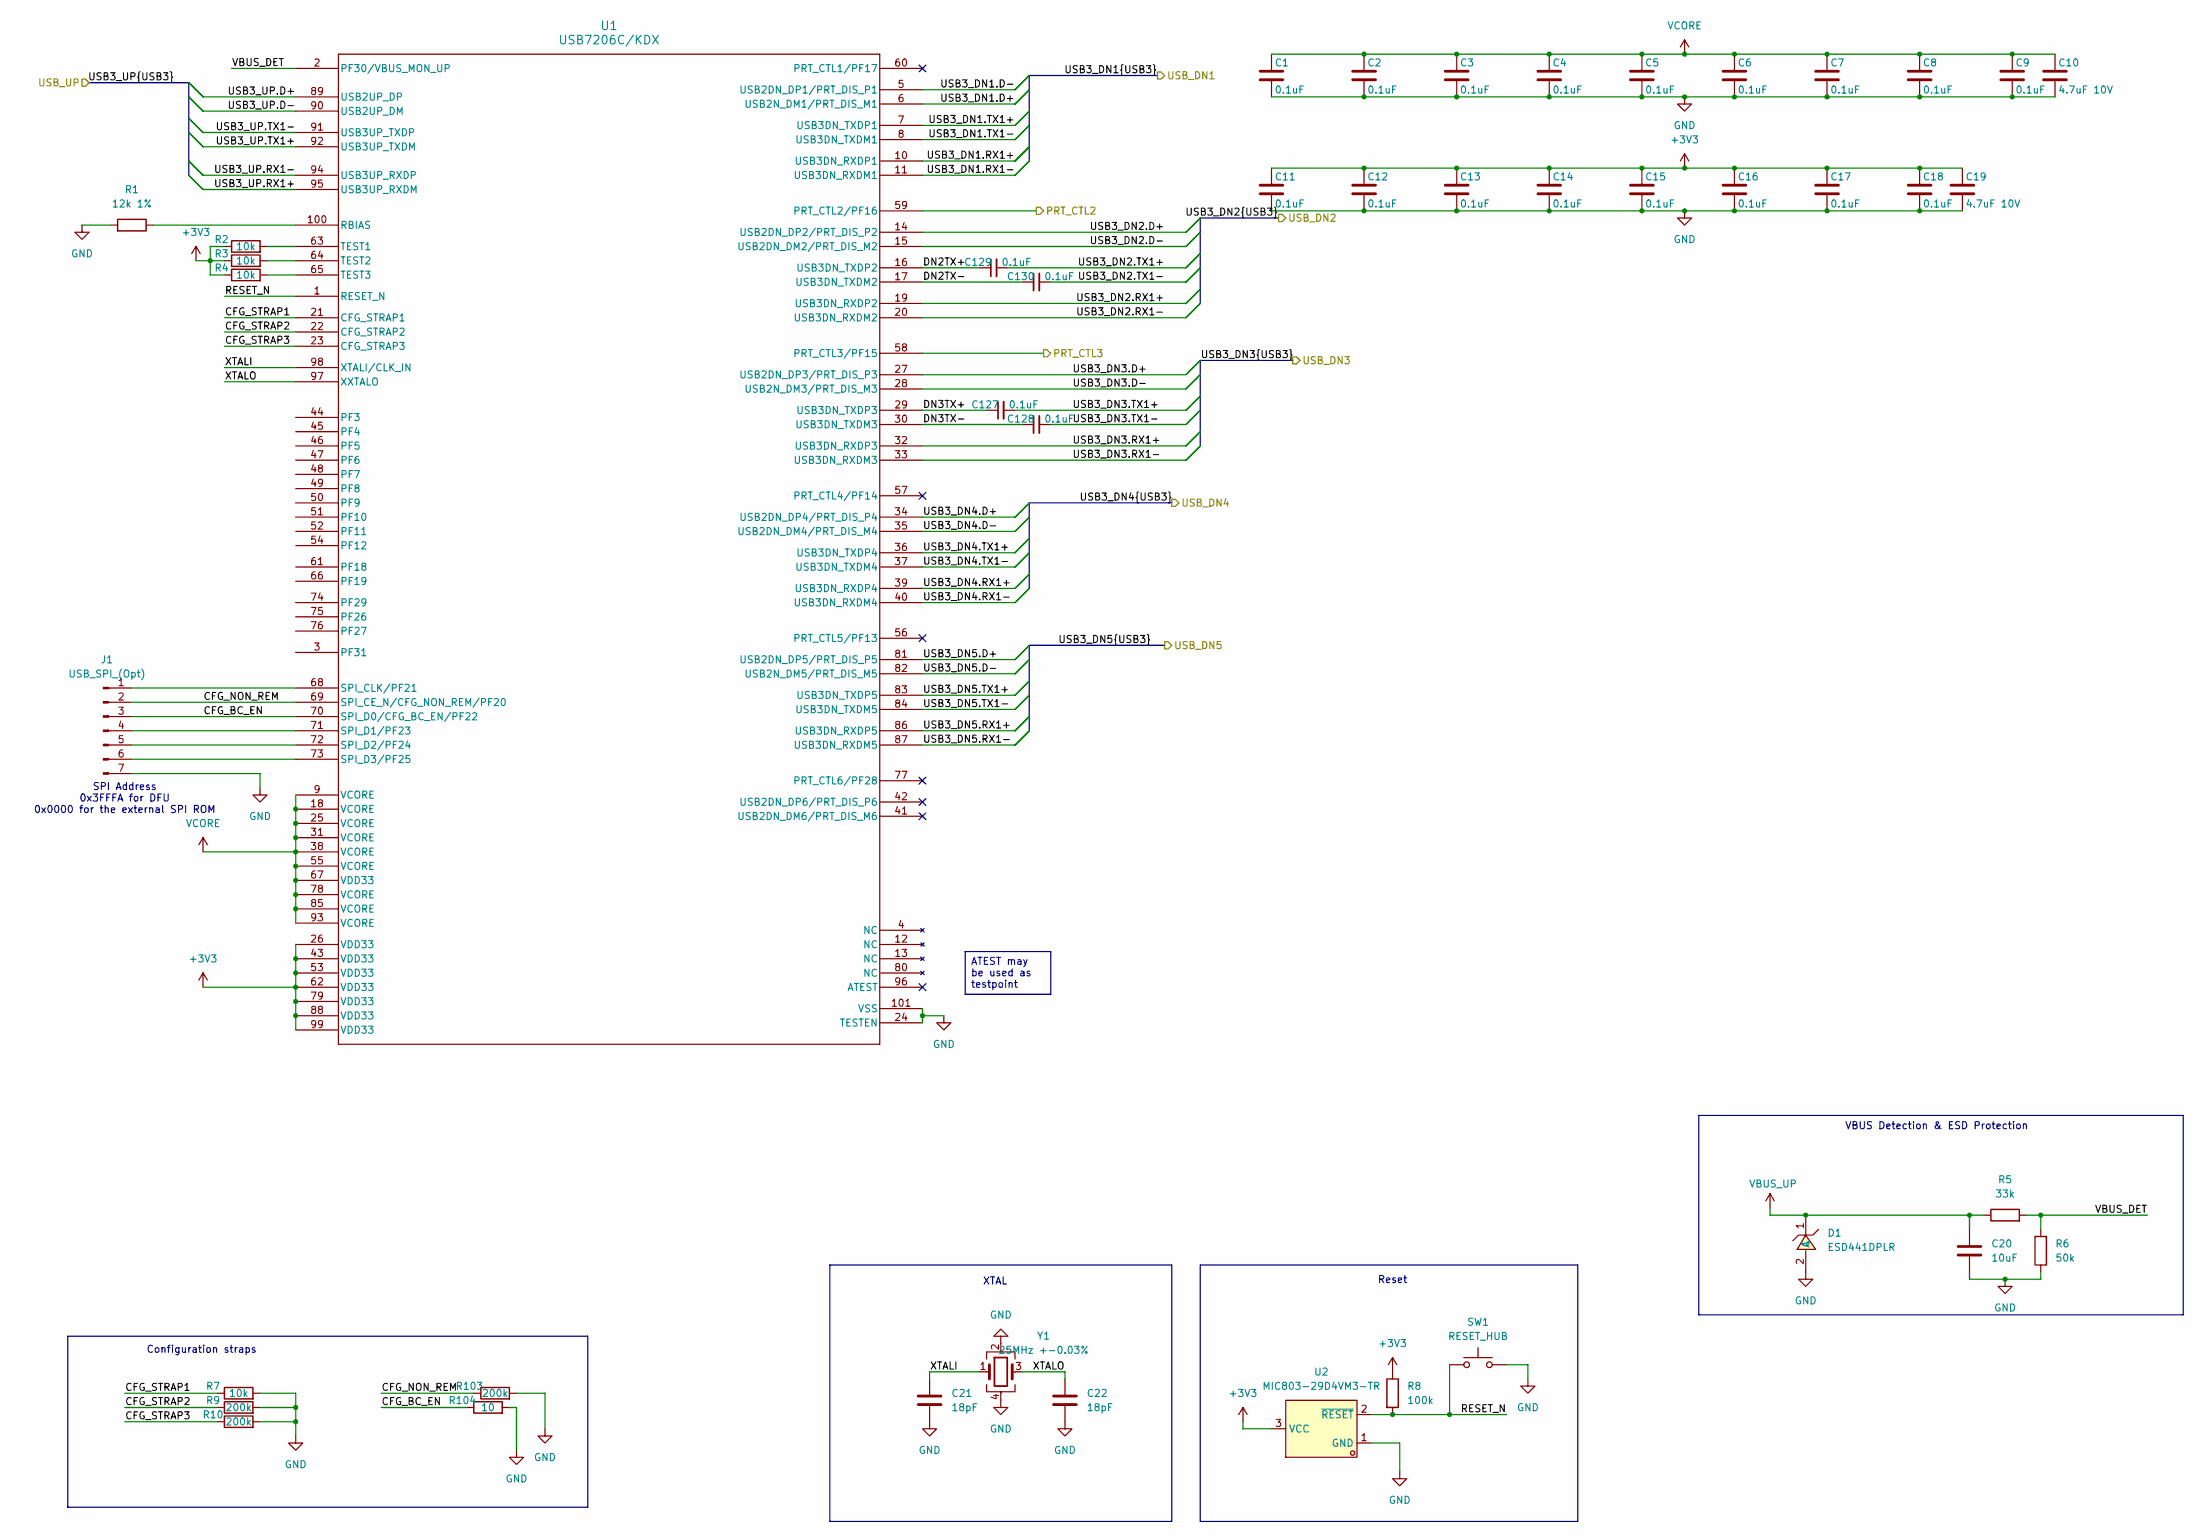
[picture p24: schematic USB7206C.kicad_sch, USB Hub]

Parts:
C1, C2, C3, C4, C5, C6, C7, C8, C9, C11, C12, C13, C14, C15, C16, C17, C18, C127, C128, C129, C130: 0.1uF; C_0201_0603Metric; LCSC Part C181043
C10, C19: 4.7uF 10V; C_0402_1005Metric; LCSC Part C318563
C20: 10uF; C_0805_2012Metric; LCSC Part C3039694
C21, C22: 18pF; C_0402_1005Metric; LCSC Part C33149
D1: ESD441DPLR; X2SON-2_L0.6-W0.3-P0.35; LCSC Part C22427765
J1: USB_SPI_(Opt); PinHeader_1x07_P1.00mm_Vertical
R1: 12k 1%; R_0402_1005Metric; LCSC Part C102781
R2, R3, R4, R7: 10k; R_0402_1005Metric; LCSC Part C25744
R5: 33k; R_0402_1005Metric; LCSC Part C25779
R6: 50k; R_0402_1005Metric; LCSC Part C166559
R8: 100k; R_0402_1005Metric; LCSC Part C25741
R9, R10, R103: 200k; R_0402_1005Metric; LCSC Part C25764
R104: 10; R_0603_1608Metric; LCSC Part C25764
SW1: RESET_HUB; ultra_small_switch_1.6x3.0mm; LCSC Part C913788
U1: USB7206C/KDX; QFN40P1200X1200X90-101N-D; Mouser Part No 579-USB7206C/KDX
U2: MIC803-29D4VM3-TR; SOT-23-3_L2.9-W1.3-P1.90-LS2.4-BR; LCSC Part C626154
Y1: 25MHz +-0.03%; Crystal_SMD_3225-4Pin_3.2x2.5mm; LCSC Part C179643

Connections:
+3V3: C11.1, C12.1, C13.1, C14.1, C15.1, C16.1, C17.1, C18.1, C19.1, R2.1, R3.1, R4.1, R8.1, U1.26 (VDD33), U1.43 (VDD33), U1.53 (VDD33), U1.62 (VDD33), U1.79 (VDD33), U1.88 (VDD33), U1.99 (VDD33), U2.3 (VCC); also elsewhere on the board
/SD-interface/USB-SD.D+: U1.34 (USB2DN_DP4/PRT_DIS_P4); also elsewhere on the board
/SD-interface/USB-SD.D-: U1.35 (USB2DN_DM4/PRT_DIS_M4); also elsewhere on the board
/SD-interface/USB-SD.RX1+: U1.39 (USB3DN_RXDP4); also elsewhere on the board
/SD-interface/USB-SD.RX1-: U1.40 (USB3DN_RXDM4); also elsewhere on the board
/SD-interface/USB-SD.TX1+: U1.36 (USB3DN_TXDP4); also elsewhere on the board
/SD-interface/USB-SD.TX1-: U1.37 (USB3DN_TXDM4); also elsewhere on the board
/USB7206C/CFG_BC_EN: J1.3, R104.1, U1.70 (SPI_D0/CFG_BC_EN/PF22)
/USB7206C/CFG_NON_REM: J1.2, R103.1, U1.69 (SPI_CE_N/CFG_NON_REM/PF20)
/USB7206C/CFG_STRAP1: R7.1, U1.21 (CFG_STRAP1)
/USB7206C/CFG_STRAP2: R9.1, U1.22 (CFG_STRAP2)
/USB7206C/CFG_STRAP3: R10.1, U1.23 (CFG_STRAP3)
/USB7206C/DN2TX+: C129.1, U1.16 (USB3DN_TXDP2)
/USB7206C/DN2TX-: C130.1, U1.17 (USB3DN_TXDM2)
/USB7206C/DN3TX+: C127.1, U1.29 (USB3DN_TXDP3)
/USB7206C/DN3TX-: C128.1, U1.30 (USB3DN_TXDM3)
/USB7206C/RESET_N: R8.2, SW1.1, U1.1 (RESET_N), U2.2 (~RESET)
/USB7206C/VBUS_DET: R5.2, R6.2, U1.2 (PF30/VBUS_MON_UP)
/USB7206C/XTALI: C21.2, U1.98 (XTALI/CLK_IN), Y1.1
/USB7206C/XTALO: C22.2, U1.97 (XXTALO), Y1.3
/USB-A1/PRT_EN1: U1.58 (PRT_CTL3/PF15); also elsewhere on the board
/USB-A1/PRT_EN2: U1.59 (PRT_CTL2/PF16); also elsewhere on the board
/USB-A1/USB-A1.D+: U1.14 (USB2DN_DP2/PRT_DIS_P2); also elsewhere on the board
/USB-A1/USB-A1.D-: U1.15 (USB2DN_DM2/PRT_DIS_M2); also elsewhere on the board
/USB-A1/USB-A1.RX1+: U1.19 (USB3DN_RXDP2); also elsewhere on the board
/USB-A1/USB-A1.RX1-: U1.20 (USB3DN_RXDM2); also elsewhere on the board
/USB-A1/USB-A1.TX1+: C129.2; also elsewhere on the board
/USB-A1/USB-A1.TX1-: C130.2; also elsewhere on the board
/USB-A1/USB-A2.D+: U1.27 (USB2DN_DP3/PRT_DIS_P3); also elsewhere on the board
/USB-A1/USB-A2.D-: U1.28 (USB2N_DM3/PRT_DIS_M3); also elsewhere on the board
/USB-A1/USB-A2.RX1+: U1.32 (USB3DN_RXDP3); also elsewhere on the board
/USB-A1/USB-A2.RX1-: U1.33 (USB3DN_RXDM3); also elsewhere on the board
/USB-A1/USB-A2.TX1+: C127.2; also elsewhere on the board
/USB-A1/USB-A2.TX1-: C128.2; also elsewhere on the board
/USB-C1/USB3_IN.D+: U1.6 (USB2N_DM1/PRT_DIS_M1); also elsewhere on the board
/USB-C1/USB3_IN.D-: U1.5 (USB2DN_DP1/PRT_DIS_P1); also elsewhere on the board
/USB-C1/USB3_IN.RX1+: U1.10 (USB3DN_RXDP1); also elsewhere on the board
/USB-C1/USB3_IN.RX1-: U1.11 (USB3DN_RXDM1); also elsewhere on the board
/USB-C1/USB3_IN.TX1+: U1.7 (USB3DN_TXDP1); also elsewhere on the board
/USB-C1/USB3_IN.TX1-: U1.8 (USB3DN_TXDM1); also elsewhere on the board
/USB-C2/USB3_IN.D+: U1.81 (USB2DN_DP5/PRT_DIS_P5); also elsewhere on the board
/USB-C2/USB3_IN.D-: U1.82 (USB2N_DM5/PRT_DIS_M5); also elsewhere on the board
/USB-C2/USB3_IN.RX1+: U1.86 (USB3DN_RXDP5); also elsewhere on the board
/USB-C2/USB3_IN.RX1-: U1.87 (USB3DN_RXDM5); also elsewhere on the board
/USB-C2/USB3_IN.TX1+: U1.83 (USB3DN_TXDP5); also elsewhere on the board
/USB-C2/USB3_IN.TX1-: U1.84 (USB3DN_TXDM5); also elsewhere on the board
/USB-C_UP1/USB3_IN.D+: U1.89 (USB2UP_DP); also elsewhere on the board
/USB-C_UP1/USB3_IN.D-: U1.90 (USB2UP_DM); also elsewhere on the board
/USB-C_UP1/USB3_IN.RX1+: U1.95 (USB3UP_RXDM); also elsewhere on the board
/USB-C_UP1/USB3_IN.RX1-: U1.94 (USB3UP_RXDP); also elsewhere on the board
/USB-C_UP1/USB3_IN.TX1+: U1.92 (USB3UP_TXDM); also elsewhere on the board
/USB-C_UP1/USB3_IN.TX1-: U1.91 (USB3UP_TXDP); also elsewhere on the board
GND: C1.2, C2.2, C3.2, C4.2, C5.2, C6.2, C7.2, C8.2, C9.2, C10.2, C11.2, C12.2, C13.2, C14.2, C15.2, C16.2, C17.2, C18.2, C19.2, C20.2, C21.1, C22.1, D1.2 (A), J1.7, R1.2, R6.1, R7.2, R9.2, R10.2, R103.2, R104.2, SW1.2, U1.24 (TESTEN), U1.101 (VSS), U2.1 (GND), Y1.2, Y1.4; also elsewhere on the board
unnamed: J1.1, U1.68 (SPI_CLK/PF21)
unnamed: J1.4, U1.71 (SPI_D1/PF23)
unnamed: J1.5, U1.72 (SPI_D2/PF24)
unnamed: J1.6, U1.73 (SPI_D3/PF25)
unnamed: R1.1, U1.100 (RBIAS)
unnamed: R2.2, U1.63 (TEST1)
unnamed: R3.2, U1.64 (TEST2)
unnamed: R4.2, U1.65 (TEST3)
VBUS_UP: C20.1, D1.1 (C), R5.1; also elsewhere on the board
VCORE: C1.1, C2.1, C3.1, C4.1, C5.1, C6.1, C7.1, C8.1, C9.1, C10.1, U1.9 (VCORE), U1.18 (VCORE), U1.25 (VCORE), U1.31 (VCORE), U1.38 (VCORE), U1.55 (VCORE), U1.67 (VDD33), U1.78 (VCORE), U1.85 (VCORE), U1.93 (VCORE); also elsewhere on the board

Notes on the sheet:
Configuration straps
SPI Address 0x3FFFA for DFU 0x0000 for the external SPI ROM
VBUS Detection & ESD Protection
XTAL
Reset
ATEST may be used as testpoint
