wozniak-works/Internal-USB-Hub/USB_hub.kicad_pcb

## KiCad design USB_hub.kicad_pcb (continued)

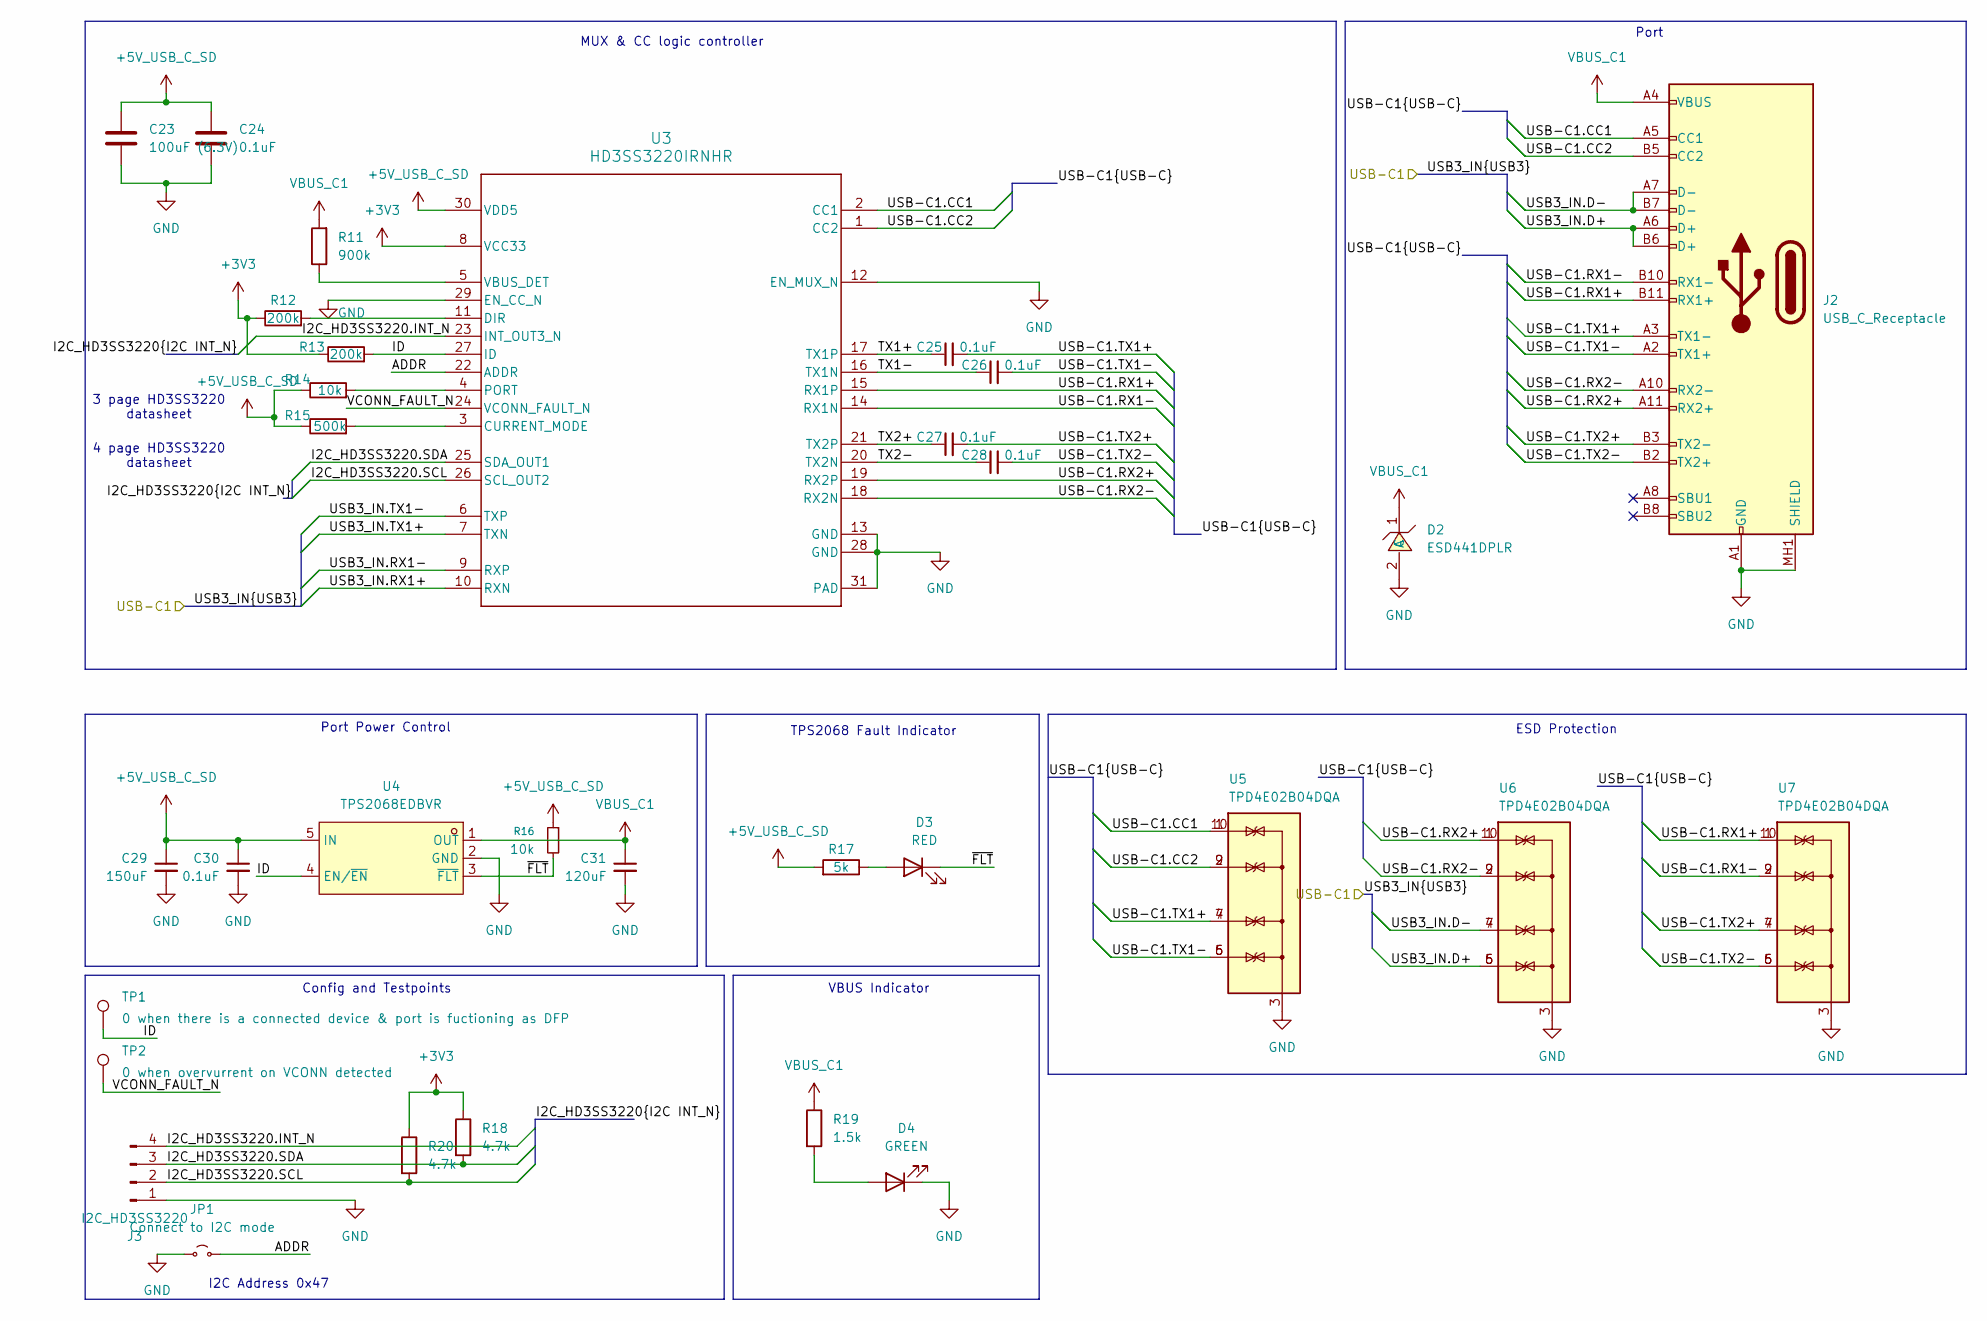
[picture p25: schematic USB-C1.kicad_sch, USB Hub]

Parts:
C23: 100uF (6.3V); C_0805_2012Metric; LCSC Part C141660
C24, C25, C26, C27, C28, C30: 0.1uF; C_0201_0603Metric; LCSC Part C181043
C29: 150uF; C_Radial_D6.3mm_H11.0mm_P2.50mm; LCSC Part C338186
C31: 120uF; C_Radial_D6.3mm_H11.0mm_P2.50mm; LCSC Part C442816
D2: ESD441DPLR; X2SON-2_L0.6-W0.3-P0.35; LCSC Part C22427765
D3: RED; LED_0603_1608Metric; LCSC Part C497918
D4: GREEN; LED_0603_1608Metric; LCSC Part C22371298
J2: USB_C_Receptacle; USB420003A; Mouser Part No 640-USB4200-03-A
J3: I2C_HD3SS3220; PinHeader_1x04_P1.00mm_Vertical
JP1: Connect to I2C mode; SolderJumper-2_P1.3mm_Open_Pad1.0x1.5mm
R11: 900k; R_1206_3216Metric; Mouser Part No 603-RT1206CRE07900KL
R12, R13: 200k; R_0402_1005Metric; LCSC Part C25764
R14, R16: 10k; R_0402_1005Metric; LCSC Part C25744
R15: 500k; R_0603_1608Metric; LCSC Part C2902631
R17: 5k; R_0402_1005Metric; LCSC Part C5948099
R18, R20: 4.7k; R_0402_1005Metric; LCSC Part C105871
R19: 1.5k; R_0402_1005Metric; LCSC Part C327253
TP1: 0 when there is a connected device & port is fuct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; TestPoint_Pad_D1.0mm
TP2: 0 when overvurrent on VCONN detected; TestPoint_Pad_D1.0mm
U3: HD3SS3220IRNHR; RNH0030A; LCSC Part C165155
U4: TPS2068EDBVR; TSOT-23-5_L2.9-W1.6-P0.95-LS2.8-BR; LCSC Part C19272843
U5, U6, U7: TPD4E02B04DQA; USON-10_2.5x1.0mm_P0.5mm; LCSC Part C106794

Connections:
+3V3: R12.1, R13.1, R18.1, R20.1, U3.8 (VCC33); also elsewhere on the board
+5V_USB_C_SD: C23.1, C24.1, C29.1, C30.1, R14.1, R15.1, R16.1, R17.2, U3.30 (VDD5), U4.5 (IN); also elsewhere on the board
/USB-C1/ADDR: JP1.2 (B), U3.22 (ADDR)
/USB-C1/I2C_HD3SS3220.INT_N: J3.4, U3.23 (INT_OUT3_N)
/USB-C1/I2C_HD3SS3220.SCL: J3.2, R20.2, U3.26 (SCL_OUT2)
/USB-C1/I2C_HD3SS3220.SDA: J3.3, R18.2, U3.25 (SDA_OUT1)
/USB-C1/ID: R13.2, TP1.1, U3.27 (ID), U4.4 (EN/~EN)
/USB-C1/TX1+: C25.1, U3.17 (TX1P)
/USB-C1/TX1-: C26.1, U3.16 (TX1N)
/USB-C1/TX2+: C27.1, U3.21 (TX2P)
/USB-C1/TX2-: C28.1, U3.20 (TX2N)
/USB-C1/USB3_IN.D+: J2.A6 (D+), J2.B6 (D+), U6.5 (IO4), U6.6 (NC); also elsewhere on the board
/USB-C1/USB3_IN.D-: J2.A7 (D-), J2.B7 (D-), U6.4 (IO3), U6.7 (NC); also elsewhere on the board
/USB-C1/USB3_IN.RX1+: U3.10 (RXN); also elsewhere on the board
/USB-C1/USB3_IN.RX1-: U3.9 (RXP); also elsewhere on the board
/USB-C1/USB3_IN.TX1+: U3.7 (TXN); also elsewhere on the board
/USB-C1/USB3_IN.TX1-: U3.6 (TXP); also elsewhere on the board
/USB-C1/USB-C1.CC1: J2.A5 (CC1), U3.2 (CC1), U5.1 (IO1), U5.10 (NC)
/USB-C1/USB-C1.CC2: J2.B5 (CC2), U3.1 (CC2), U5.2 (IO2), U5.9 (NC)
/USB-C1/USB-C1.RX1+: J2.B11 (RX1+), U3.15 (RX1P), U7.1 (IO1), U7.10 (NC)
/USB-C1/USB-C1.RX1-: J2.B10 (RX1-), U3.14 (RX1N), U7.2 (IO2), U7.9 (NC)
/USB-C1/USB-C1.RX2+: J2.A11 (RX2+), U3.19 (RX2P), U6.1 (IO1), U6.10 (NC)
/USB-C1/USB-C1.RX2-: J2.A10 (RX2-), U3.18 (RX2N), U6.2 (IO2), U6.9 (NC)
/USB-C1/USB-C1.TX1+: C25.2, J2.A3 (TX1-), U5.4 (IO3), U5.7 (NC)
/USB-C1/USB-C1.TX1-: C26.2, J2.A2 (TX1+), U5.5 (IO4), U5.6 (NC)
/USB-C1/USB-C1.TX2+: C27.2, J2.B3 (TX2-), U7.4 (IO3), U7.7 (NC)
/USB-C1/USB-C1.TX2-: C28.2, J2.B2 (TX2+), U7.5 (IO4), U7.6 (NC)
/USB-C1/VCONN_FAULT_N: TP2.1, U3.24 (VCONN_FAULT_N)
/USB-C1/~FLT: D3.1 (K), R16.2, U4.3 (~FLT)
GND: C23.2, C24.2, C29.2, C30.2, C31.2, D2.2 (A), D4.1 (K), J2.A1 (GND), J2.A12 (GND), J2.B1 (GND), J2.B12 (GND), J2.MH1 (SHIELD), J2.MH2 (SHIELD), J2.MH3 (SHIELD), J2.MH4 (SHIELD), J3.1, JP1.1 (A), U3.12 (EN_MUX_N), U3.13 (GND), U3.28 (GND), U3.29 (EN_CC_N), U3.31 (PAD), U4.2 (GND), U5.3 (G), U5.8 (G), U6.3 (G), U6.8 (G), U7.3 (G), U7.8 (G); also elsewhere on the board
unnamed: D3.2 (A), R17.1
unnamed: D4.2 (A), R19.2
unnamed: R15.2, U3.3 (CURRENT_MODE)
unnamed: R12.2, U3.11 (DIR)
unnamed: R14.2, U3.4 (PORT)
unnamed: R11.1, U3.5 (VBUS_DET)
VBUS_C1: C31.1, D2.1 (C), J2.A4 (VBUS), J2.A9 (VBUS), J2.B4 (VBUS), J2.B9 (VBUS), R11.2, R19.1, U4.1 (OUT)

Notes on the sheet:
TPS2068 Fault Indicator
4 page HD3SS3220 datasheet
I2C Address 0x47
3 page HD3SS3220 datasheet
Port
VBUS Indicator
Config and Testpoints
Port Power Control
ESD Protection
MUX & CC logic controller

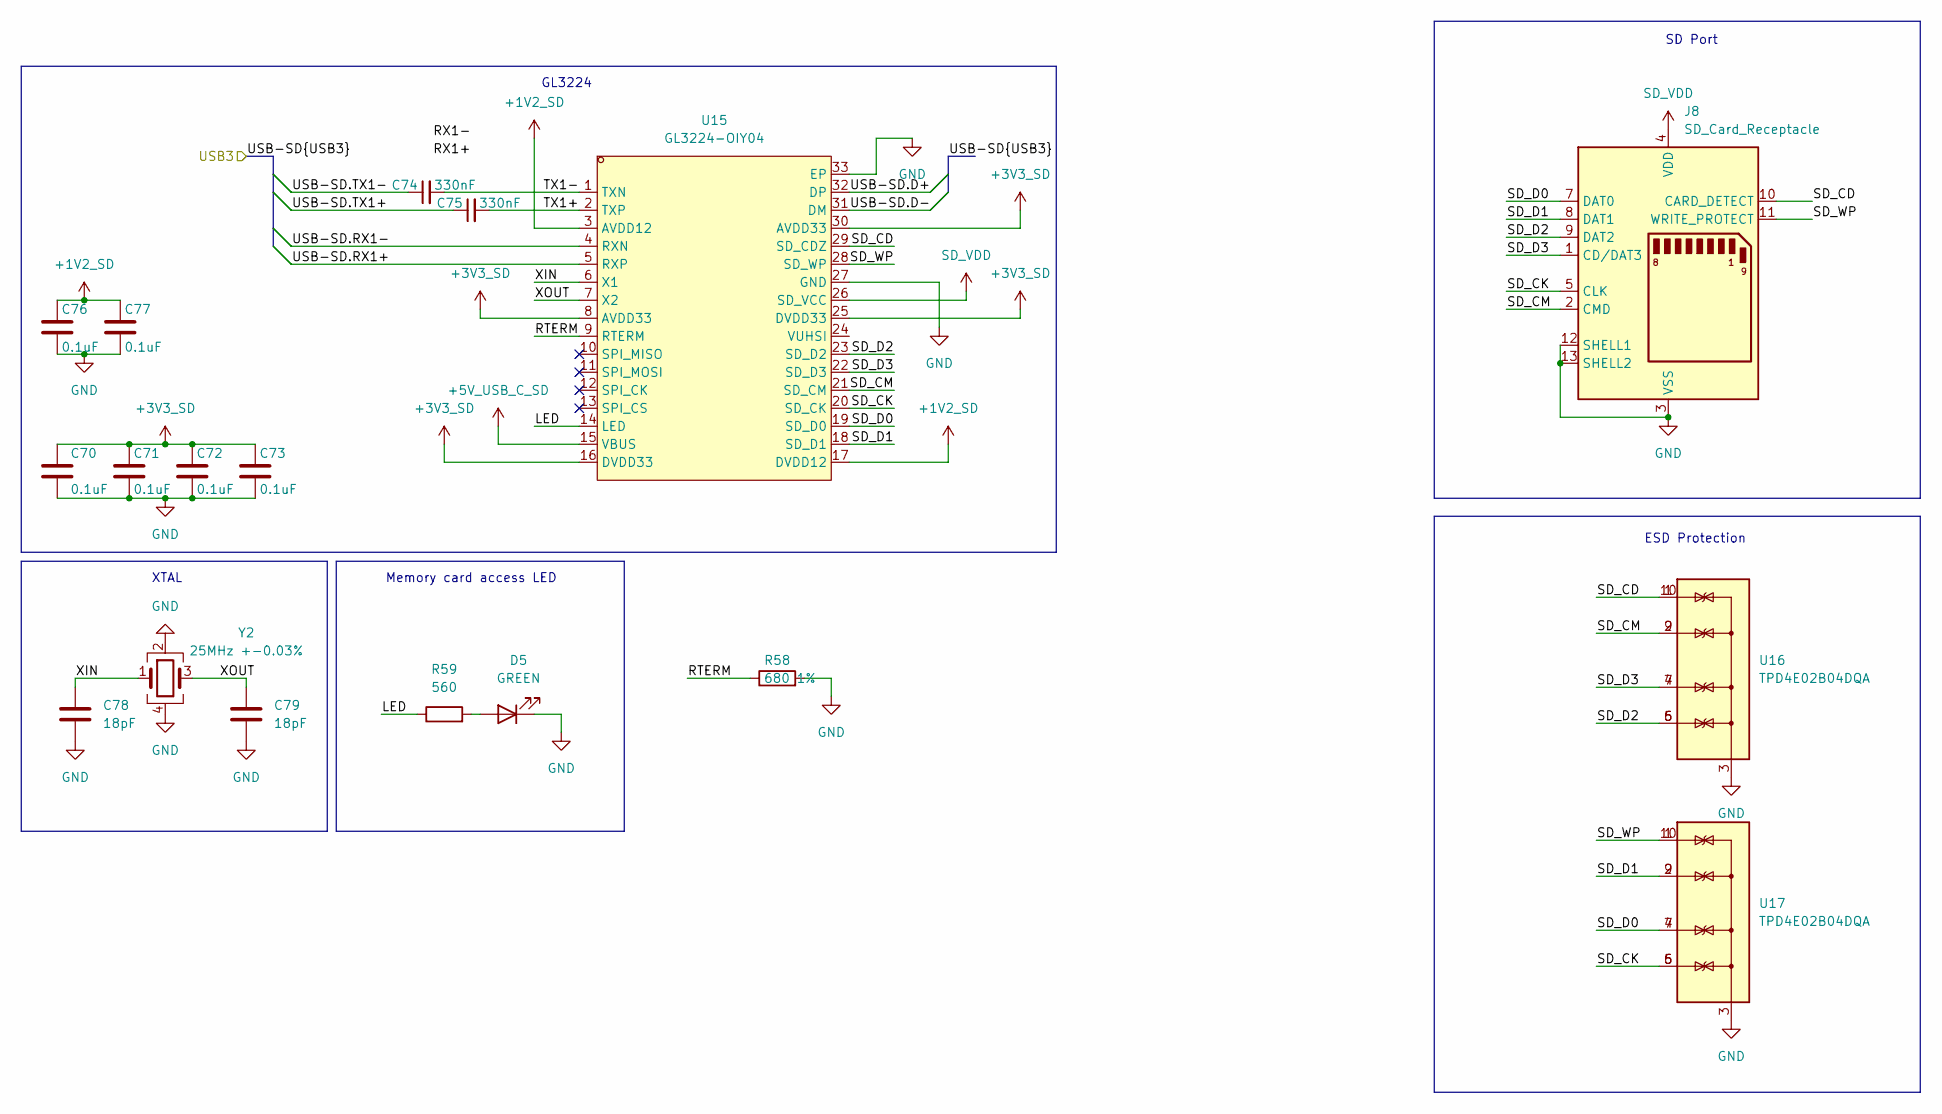
[picture p26: schematic SD-interface.kicad_sch, USB Hub]

Parts:
C70, C71, C72, C73, C76, C77: 0.1uF; C_0201_0603Metric; LCSC Part C181043
C74, C75: 330nF; C_0201_0603Metric; LCSC Part C2980695
C78, C79: 18pF; C_0402_1005Metric; LCSC Part C33149
D5: GREEN; LED_0603_1608Metric; LCSC Part C22371298
J8: SD_Card_Receptacle; SD2A; Mouser Part No 179-SD-2-A
R58: 680 1%; R_0402_1005Metric; LCSC Part C25130
R59: 560; R_0402_1005Metric; LCSC Part C137858
U15: GL3224-OIY04; HQFN-32_L5.0-W5.0-P0.50-BL-EP3.0; LCSC Part C157357
U16, U17: TPD4E02B04DQA; USON-10_2.5x1.0mm_P0.5mm; LCSC Part C106794
Y2: 25MHz +-0.03%; Crystal_SMD_3225-4Pin_3.2x2.5mm; LCSC Part C179643

Connections:
+1V2_SD: C76.1, C77.1, U15.3 (AVDD12), U15.17 (DVDD12)
+3V3_SD: C70.1, C71.1, C72.1, C73.1, U15.8 (AVDD33), U15.16 (DVDD33), U15.25 (DVDD33), U15.30 (AVDD33)
+5V_USB_C_SD: U15.15 (VBUS); also elsewhere on the board
/SD-interface/LED: R59.1, U15.14 (LED)
/SD-interface/RTERM: R58.1, U15.9 (RTERM)
/SD-interface/SD_CD: J8.10 (CARD_DETECT), U15.29 (SD_CDZ), U16.1 (IO1), U16.10 (NC)
/SD-interface/SD_CK: J8.5 (CLK), U15.20 (SD_CK), U17.5 (IO4), U17.6 (NC)
/SD-interface/SD_CM: J8.2 (CMD), U15.21 (SD_CM), U16.2 (IO2), U16.9 (NC)
/SD-interface/SD_D0: J8.7 (DAT0), U15.19 (SD_D0), U17.4 (IO3), U17.7 (NC)
/SD-interface/SD_D1: J8.8 (DAT1), U15.18 (SD_D1), U17.2 (IO2), U17.9 (NC)
/SD-interface/SD_D2: J8.9 (DAT2), U15.23 (SD_D2), U16.5 (IO4), U16.6 (NC)
/SD-interface/SD_D3: J8.1 (CD/DAT3), U15.22 (SD_D3), U16.4 (IO3), U16.7 (NC)
/SD-interface/SD_WP: J8.11 (WRITE_PROTECT), U15.28 (SD_WP), U17.1 (IO1), U17.10 (NC)
/SD-interface/TX1+: C75.2, U15.2 (TXP)
/SD-interface/TX1-: C74.2, U15.1 (TXN)
/SD-interface/USB-SD.D+: U15.32 (DP); also elsewhere on the board
/SD-interface/USB-SD.D-: U15.31 (DM); also elsewhere on the board
/SD-interface/USB-SD.RX1+: U15.5 (RXP); also elsewhere on the board
/SD-interface/USB-SD.RX1-: U15.4 (RXN); also elsewhere on the board
/SD-interface/USB-SD.TX1+: C75.1; also elsewhere on the board
/SD-interface/USB-SD.TX1-: C74.1; also elsewhere on the board
/SD-interface/XIN: C78.2, U15.6 (X1), Y2.1
/SD-interface/XOUT: C79.2, U15.7 (X2), Y2.3
GND: C70.2, C71.2, C72.2, C73.2, C76.2, C77.2, C78.1, C79.1, D5.1 (K), J8.3 (VSS), J8.6 (VSS), J8.12 (SHELL1), J8.13 (SHELL2), R58.2, U15.27 (GND), U15.33 (EP), U16.3 (G), U16.8 (G), U17.3 (G), U17.8 (G), Y2.2, Y2.4; also elsewhere on the board
unnamed: D5.2 (A), R59.2
SD_VDD: J8.4 (VDD), U15.26 (SD_VCC)

Notes on the sheet:
Memory card access LED
ESD Protection
SD Port
GL3224
XTAL

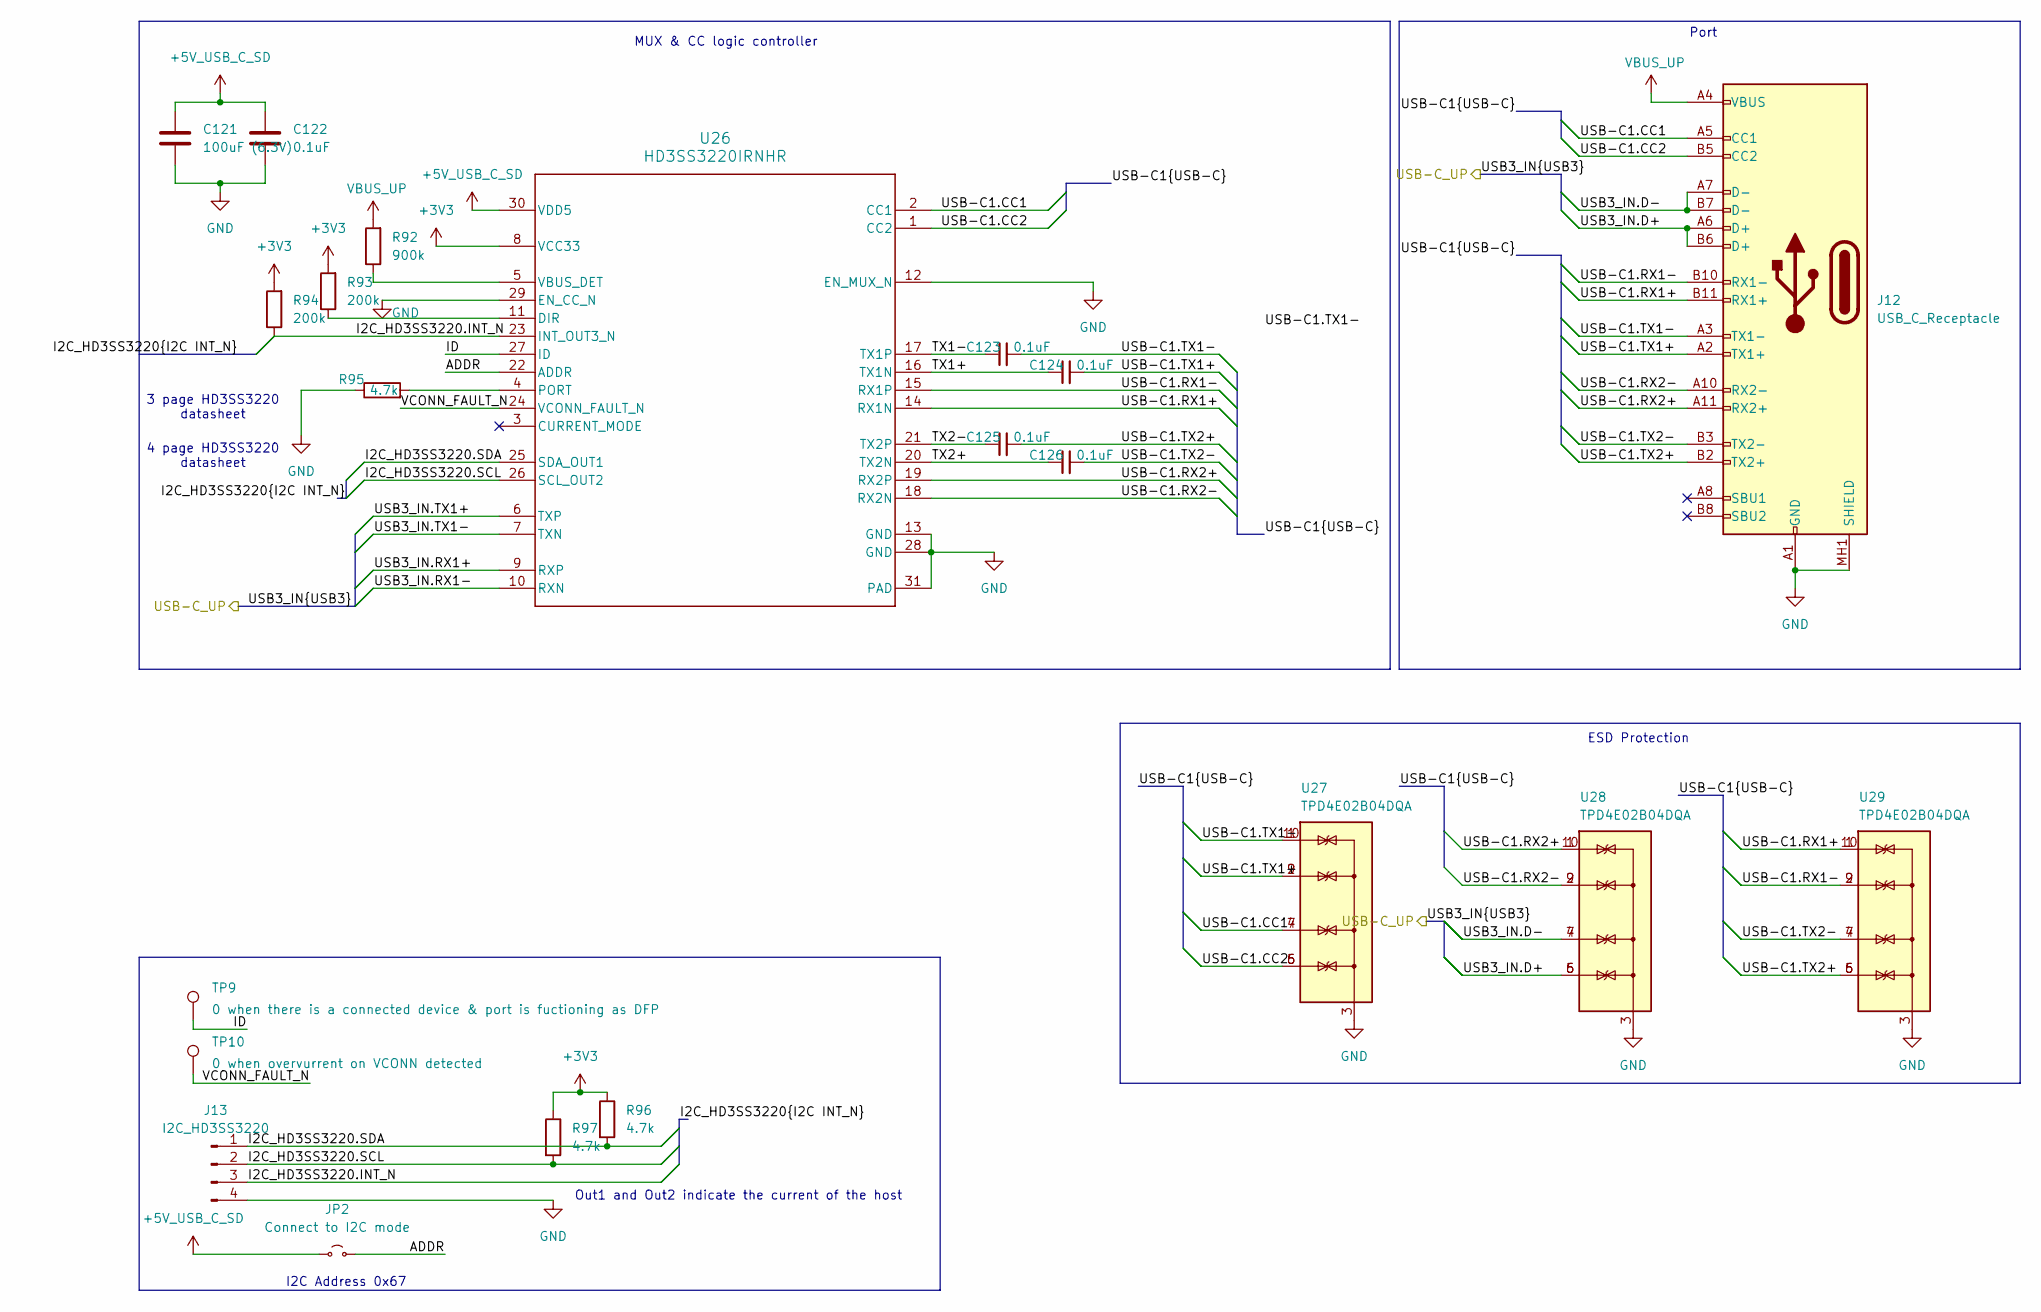
[picture p27: schematic USB-C_UP1.kicad_sch, USB Hub]

Parts:
C121: 100uF (6.3V); C_0805_2012Metric; LCSC Part C141660
C122, C123, C124, C125, C126: 0.1uF; C_0201_0603Metric; LCSC Part C181043
J12: USB_C_Receptacle; DX07S024XJ1R1100; LCSC Part C134113
J13: I2C_HD3SS3220; PinHeader_1x04_P1.00mm_Vertical
JP2: Connect to I2C mode; SolderJumper-2_P1.3mm_Open_RoundedPad1.0x1.5mm
R92: 900k; R_1206_3216Metric; Mouser Part No 603-RT1206CRE07900KL
R93, R94: 200k; R_0402_1005Metric; LCSC Part C25764
R95, R96, R97: 4.7k; R_0402_1005Metric; LCSC Part C105871
TP9: 0 when there is a connected device & port is fuct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; TestPoint_Pad_D1.0mm
TP10: 0 when overvurrent on VCONN detected; TestPoint_Pad_D1.0mm
U26: HD3SS3220IRNHR; RNH0030A; LCSC Part C165155
U27, U28, U29: TPD4E02B04DQA; USON-10_2.5x1.0mm_P0.5mm; LCSC Part C106794

Connections:
+3V3: R93.2, R94.2, R96.1, R97.1, U26.8 (VCC33); also elsewhere on the board
+5V_USB_C_SD: C121.1, C122.1, JP2.1 (A), U26.30 (VDD5); also elsewhere on the board
/USB-C_UP1/ADDR: JP2.2 (B), U26.22 (ADDR)
/USB-C_UP1/I2C_HD3SS3220.INT_N: J13.3, R94.1, U26.23 (INT_OUT3_N)
/USB-C_UP1/I2C_HD3SS3220.SCL: J13.2, R97.2, U26.26 (SCL_OUT2)
/USB-C_UP1/I2C_HD3SS3220.SDA: J13.1, R96.2, U26.25 (SDA_OUT1)
/USB-C_UP1/ID: TP9.1, U26.27 (ID)
/USB-C_UP1/TX1+: C124.1, U26.16 (TX1N)
/USB-C_UP1/TX1-: C123.1, U26.17 (TX1P)
/USB-C_UP1/TX2+: C126.1, U26.20 (TX2N)
/USB-C_UP1/TX2-: C125.1, U26.21 (TX2P)
/USB-C_UP1/USB3_IN.D+: J12.A6 (D+), J12.B6 (D+), U28.5 (IO4), U28.6 (NC); also elsewhere on the board
/USB-C_UP1/USB3_IN.D-: J12.A7 (D-), J12.B7 (D-), U28.4 (IO3), U28.7 (NC); also elsewhere on the board
/USB-C_UP1/USB3_IN.RX1+: U26.9 (RXP); also elsewhere on the board
/USB-C_UP1/USB3_IN.RX1-: U26.10 (RXN); also elsewhere on the board
/USB-C_UP1/USB3_IN.TX1+: U26.6 (TXP); also elsewhere on the board
/USB-C_UP1/USB3_IN.TX1-: U26.7 (TXN); also elsewhere on the board
/USB-C_UP1/USB-C1.CC1: J12.A5 (CC1), U26.2 (CC1), U27.4 (IO3), U27.7 (NC)
/USB-C_UP1/USB-C1.CC2: J12.B5 (CC2), U26.1 (CC2), U27.5 (IO4), U27.6 (NC)
/USB-C_UP1/USB-C1.RX1+: J12.B11 (RX1+), U26.14 (RX1N), U29.1 (IO1), U29.10 (NC)
/USB-C_UP1/USB-C1.RX1-: J12.B10 (RX1-), U26.15 (RX1P), U29.2 (IO2), U29.9 (NC)
/USB-C_UP1/USB-C1.RX2+: J12.A11 (RX2+), U26.19 (RX2P), U28.1 (IO1), U28.10 (NC)
/USB-C_UP1/USB-C1.RX2-: J12.A10 (RX2-), U26.18 (RX2N), U28.2 (IO2), U28.9 (NC)
/USB-C_UP1/USB-C1.TX1+: C124.2, J12.A2 (TX1+), U27.2 (IO2), U27.9 (NC)
/USB-C_UP1/USB-C1.TX1-: C123.2, J12.A3 (TX1-), U27.1 (IO1), U27.10 (NC)
/USB-C_UP1/USB-C1.TX2+: C125.2, J12.B2 (TX2+), U29.5 (IO4), U29.6 (NC)
/USB-C_UP1/USB-C1.TX2-: C126.2, J12.B3 (TX2-), U29.4 (IO3), U29.7 (NC)
/USB-C_UP1/VCONN_FAULT_N: TP10.1, U26.24 (VCONN_FAULT_N)
GND: C121.2, C122.2, J12.A1 (GND), J12.A12 (GND), J12.B1 (GND), J12.B12 (GND), J12.MH1 (SHIELD), J12.MH2 (SHIELD), J12.MH3 (SHIELD), J12.MH4 (SHIELD), J13.4, R95.1, U26.12 (EN_MUX_N), U26.13 (GND), U26.28 (GND), U26.29 (EN_CC_N), U26.31 (PAD), U27.3 (G), U27.8 (G), U28.3 (G), U28.8 (G), U29.3 (G), U29.8 (G); also elsewhere on the board
unnamed: R93.1, U26.11 (DIR)
unnamed: R95.2, U26.4 (PORT)
unnamed: R92.1, U26.5 (VBUS_DET)
VBUS_UP: J12.A4 (VBUS), J12.A9 (VBUS), J12.B4 (VBUS), J12.B9 (VBUS), R92.2; also elsewhere on the board

Notes on the sheet:
4 page HD3SS3220 datasheet
3 page HD3SS3220 datasheet
Port
Out1 and Out2 indicate the current of the host
I2C Address 0x67
ESD Protection
MUX & CC logic controller

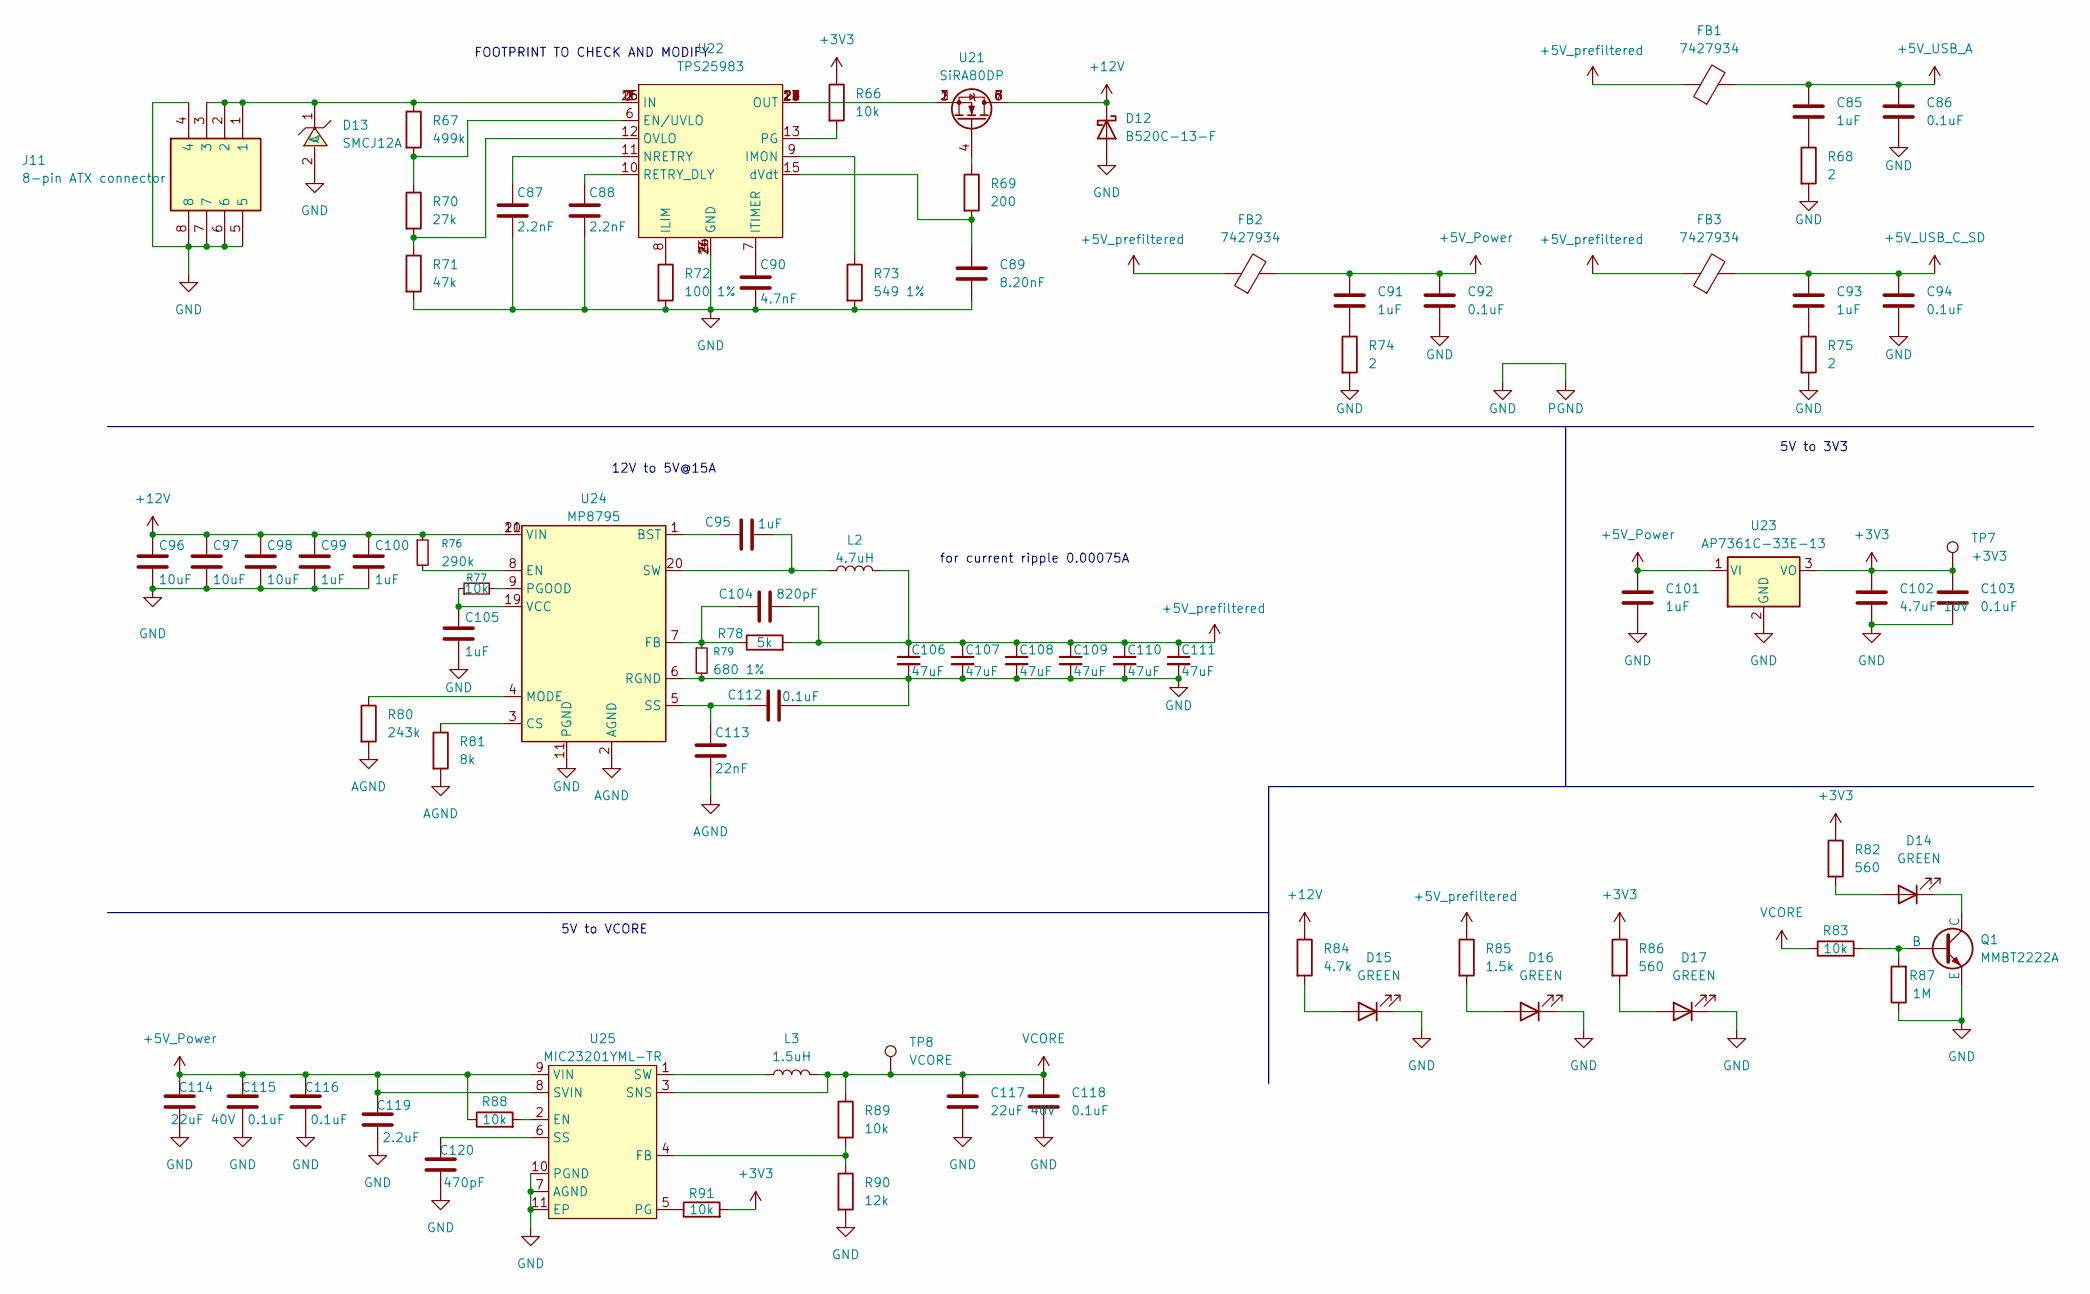
[picture p28: schematic Power.kicad_sch, USB Hub]

Parts:
C85, C91, C93, C95, C99, C100, C101, C105: 1uF; C_0603_1608Metric; LCSC Part C5199872
C86, C92, C94, C103, C112, C115, C116, C118: 0.1uF; C_0201_0603Metric; LCSC Part C181043
C87, C88: 2.2nF; C_0402_1005Metric; LCSC Part C513667
C89: 8.20nF; C_0402_1005Metric; LCSC Part C541457
C90: 4.7nF; C_0402_1005Metric; LCSC Part C281757
C96, C97, C98: 10uF; C_0805_2012Metric; LCSC Part C3039694
C102: 4.7uF 10V; C_0402_1005Metric; LCSC Part C318563
C104: 820pF; C_0402_1005Metric; LCSC Part C114386
C106, C107, C108, C109, C110, C111: 47uF; C_Radial_D5.0mm_H11.0mm_P2.00mm; LCSC Part C721300
C113: 22nF; C_0402_1005Metric; LCSC Part C77023
C114, C117: 22uF 40V; C_1206_3216Metric; LCSC Part C309062
C119: 2.2uF; C_0402_1005Metric; LCSC Part C2999759
C120: 470pF; C_0402_1005Metric; LCSC Part C272887
D12: B520C-13-F; D_SMC; LCSC Part C134460
D13: SMCJ12A; D_SMC; LCSC Part C224038
D14, D15, D16, D17: GREEN; LED_0603_1608Metric; LCSC Part C22371298
FB1, FB2, FB3: 7427934; Mouser Part No 710-7427934
J11: 8-pin ATX connector; 45586-000Y; Manufacturer_Part_Number 45586-0005; Mouser Part No 538-45586-0005
L2: 4.7uH; L_Coilcraft_XAL1010-XXX; LCSC Part C18199458
L3: 1.5uH; L_6.3x6.3_H3; LCSC Part C520330
Q1: MMBT2222A; SOT-23-3; LCSC Part C82460
R66, R77, R83, R88, R89, R91: 10k; R_0402_1005Metric; LCSC Part C25744
R67: 499k; R_0402_1005Metric; LCSC Part C137971
R68, R74, R75: 2; R_0603_1608Metric; LCSC Part C2907139
R69: 200; R_0402_1005Metric; LCSC Part C114764
R70: 27k; R_0402_1005Metric; LCSC Part C138022
R71: 47k; R_0402_1005Metric; LCSC Part C93943
R72: 100 1%; R_0402_1005Metric; LCSC Part C106232
R73: 549 1%; R_0402_1005Metric; LCSC Part C7334458
R76: 290k; R_0402_1005Metric; LCSC Part C5126158
R78: 5k; R_0402_1005Metric; LCSC Part C5948099
R79: 680 1%; R_0402_1005Metric; LCSC Part C25130
R80: 243k; R_0402_1005Metric; LCSC Part C2998149
R81: 8k; R_0603_1608Metric; LCSC Part C862307
R82, R86: 560; R_0402_1005Metric; LCSC Part C137858
R84: 4.7k; R_0402_1005Metric; LCSC Part C105871
R85: 1.5k; R_0402_1005Metric; LCSC Part C327253
R87: 1M; R_0402_1005Metric; LCSC Part C2906900
R90: 12k; R_0402_1005Metric; LCSC Part C413006
TP7: +3V3; TestPoint_Pad_D1.0mm
TP8: VCORE; TestPoint_Pad_D1.0mm
U21: SiRA80DP; PowerPAK_SO-8L_Single; LCSC Part C3289458
U22: TPS25983; TPS259830ONRGER; LCSC Part C20611808
U23: AP7361C-33E-13; SOT-223-3_TabPin2; LCSC Part C500795
U24: MP8795; MPS-QFN-21_3x4mm; Mouser Part No 946-MP8795GLE-Z
U25: MIC23201YML-TR; TDFN-10_L3.0-W3.0-P0.50-TL-EP; LCSC Part C621769

Connections:
+3V3: C102.1, C103.1, R66.1, R82.1, R86.1, R91.2, TP7.1, U23.3 (VO); also elsewhere on the board
+5V_Power: C91.1, C92.1, C101.1, C114.1, C115.1, C116.1, C119.1, FB2.2, R88.1, U23.1 (VI), U25.8 (SVIN), U25.9 (VIN)
+5V_USB_A: C85.1, C86.1, FB1.2; also elsewhere on the board
+5V_USB_C_SD: C93.1, C94.1, FB3.2; also elsewhere on the board
+5V_prefiltered: C104.2, C106.1, C107.1, C108.1, C109.1, C110.1, C111.1, FB1.1, FB2.1, FB3.1, L2.2, R78.2, R85.1
+12V: C96.1, C97.1, C98.1, C99.1, C100.1, D12.1 (K), R76.1, R84.1, U21.5 (D), U21.6 (D), U21.7 (D), U21.8 (D), U24.10 (VIN), U24.21 (VIN); also elsewhere on the board
AGND: C113.2, R80.2, R81.2, U24.2 (AGND)
GND: C86.2, C87.2, C88.2, C89.2, C90.2, C92.2, C94.2, C96.2, C97.2, C98.2, C99.2, C100.2, C101.2, C102.2, C103.2, C105.2, C106.2, C107.2, C108.2, C109.2, C110.2, C111.2, C112.2, C114.2, C115.2, C116.2, C117.2, C118.2, C119.2, C120.2, D12.2 (A), D13.2 (A), D15.1 (K), D16.1 (K), D17.1 (K), J11.4, J11.5, J11.6, J11.7, J11.8, Q1.3 (E), R68.2, R71.2, R72.2, R73.2, R74.2, R75.2, R79.2, R87.1, R90.2, U22.4 (GND), U22.5 (GND), U22.14 (GND), U22.26 (GND), U23.2 (GND), U24.6 (RGND), U24.11 (PGND), U25.7 (AGND), U25.10 (PGND), U25.11 (EP); also elsewhere on the board
unnamed: C85.2, R68.1
unnamed: C91.2, R74.1
unnamed: C93.2, R75.1
unnamed: D13.1 (C), J11.1, J11.2, J11.3, R67.1, U22.1 (IN), U22.2 (IN), U22.3 (IN), U22.16 (IN), U22.25 (IN)
unnamed: D14.2 (A), R82.2
unnamed: D14.1 (K), Q1.1 (C)
unnamed: D15.2 (A), R84.2
unnamed: D16.2 (A), R85.2
unnamed: D17.2 (A), R86.2
unnamed: Q1.2 (B), R83.2, R87.2
unnamed: R69.1, U21.4 (G)
unnamed: U21.1 (S), U21.2 (S), U21.3 (S), U22.17 (OUT), U22.18 (OUT), U22.19 (OUT), U22.20 (OUT), U22.21 (OUT), U22.22 (OUT), U22.23 (OUT), U22.24 (OUT)
unnamed: R67.2, R70.1, U22.6 (EN/UVLO)
unnamed: R72.1, U22.8 (ILIM)
unnamed: R73.1, U22.9 (IMON)
unnamed: C90.1, U22.7 (ITIMER)
unnamed: C87.1, U22.11 (NRETRY)
unnamed: R70.2, R71.1, U22.12 (OVLO)
unnamed: R66.2, U22.13 (PG)
unnamed: C88.1, U22.10 (RETRY_DLY)
unnamed: C89.1, R69.2, U22.15 (dVdt)
unnamed: C95.1, U24.1 (BST)
unnamed: R81.1, U24.3 (CS)
unnamed: R76.2, U24.8 (EN)
unnamed: C104.1, R78.1, R79.1, U24.7 (FB)
unnamed: R80.1, U24.4 (MODE)
unnamed: R77.2, U24.9 (PGOOD)
unnamed: C112.1, C113.1, U24.5 (SS)
unnamed: C95.2, L2.1, U24.20 (SW)
unnamed: C105.1, R77.1, U24.19 (VCC)
unnamed: R88.2, U25.2 (EN)
unnamed: R89.2, R90.1, U25.4 (FB)
unnamed: R91.1, U25.5 (PG)
unnamed: C120.1, U25.6 (SS)
unnamed: L3.1, U25.1 (SW)
VCORE: C117.1, C118.1, L3.2, R83.1, R89.1, TP8.1, U25.3 (SNS); also elsewhere on the board

Notes on the sheet:
FOOTPRINT TO CHECK AND MODIFY
5V to VCORE
12V to 5V@15A
5V to 3V3
for current ripple 0.00075A

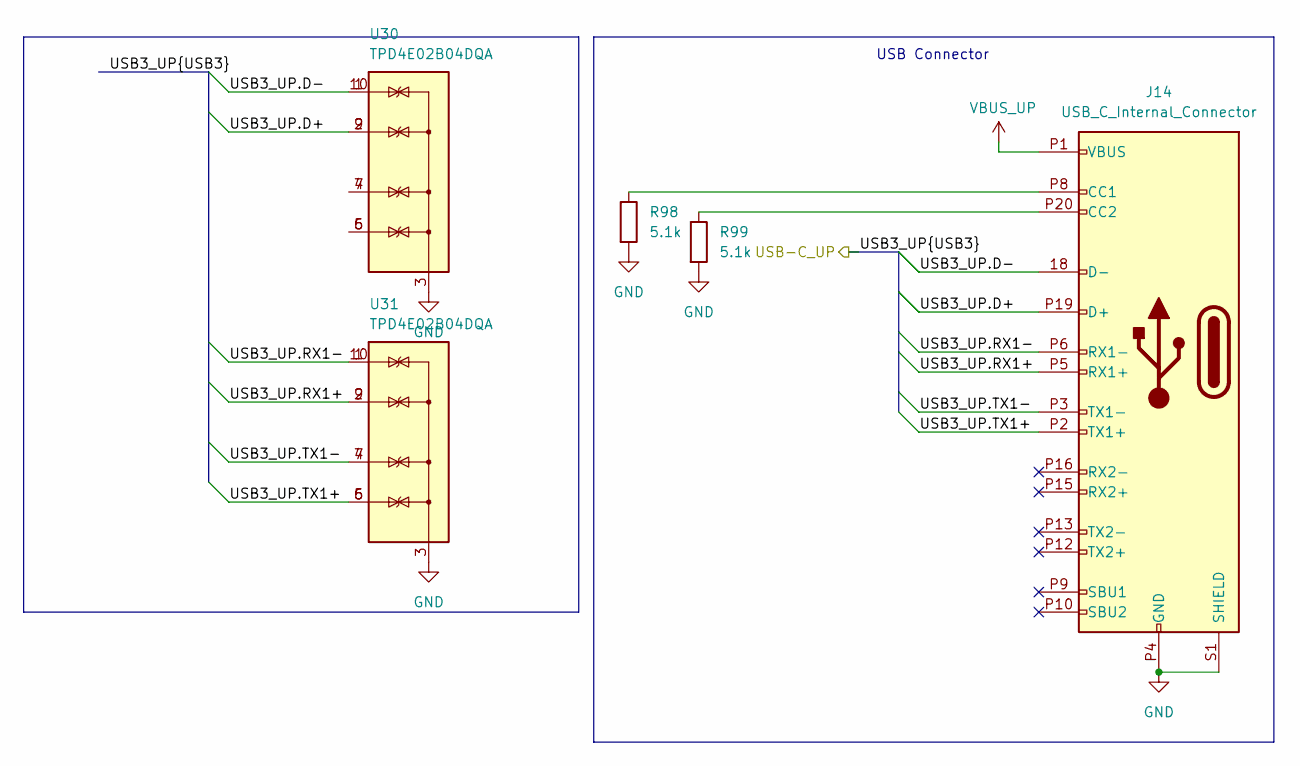
[picture p29: schematic USB-E_UP.kicad_sch, USB Hub]

Parts:
J14: USB_C_Internal_Connector
R98, R99: 5.1k; LCSC Part C2906948
U30, U31: TPD4E02B04DQA; USON-10_2.5x1.0mm_P0.5mm; LCSC Part C106794

Connections:
unnamed: J14.18 (D-), U30.1 (IO1), U30.10 (NC)
unnamed: J14.P1 (VBUS), J14.P7 (VBUS), J14.P11 (VBUS)
unnamed: J14.P2 (TX1+), U31.5 (IO4), U31.6 (NC)
unnamed: J14.P3 (TX1-), U31.4 (IO3), U31.7 (NC)
unnamed: J14.P5 (RX1+), U31.2 (IO2), U31.9 (NC)
unnamed: J14.P6 (RX1-), U31.1 (IO1), U31.10 (NC)
unnamed: J14.P8 (CC1), R98.1
unnamed: J14.P4 (GND), J14.P14 (GND), J14.P17 (GND), J14.S1 (SHIELD), R98.2, R99.2, U30.3 (G), U30.8 (G), U31.3 (G), U31.8 (G)
unnamed: J14.P19 (D+), U30.2 (IO2), U30.9 (NC)
unnamed: J14.P20 (CC2), R99.1
unnamed: U30.4 (IO3), U30.7 (NC)
unnamed: U30.5 (IO4), U30.6 (NC)

Notes on the sheet:
USB Connector
