wozniak-works/Internal-USB-Hub/USB_hub.kicad_pcb

## KiCad design USB_hub.kicad_pcb (continued)

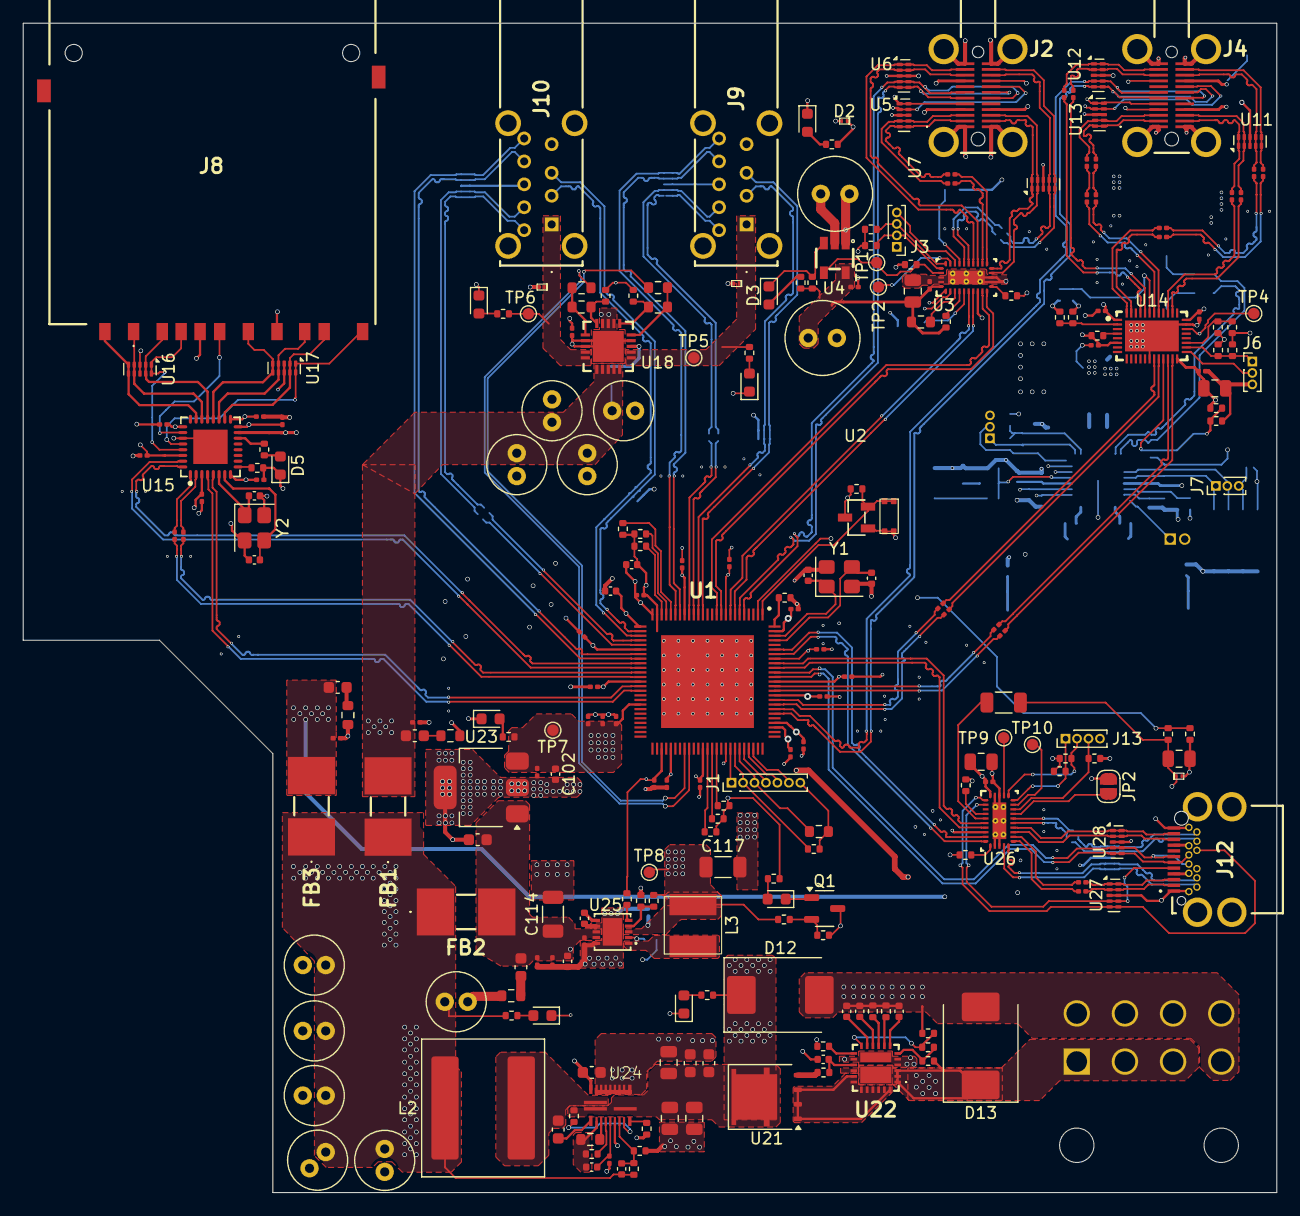
[picture p30: board USB_hub.kicad_pcb from above]

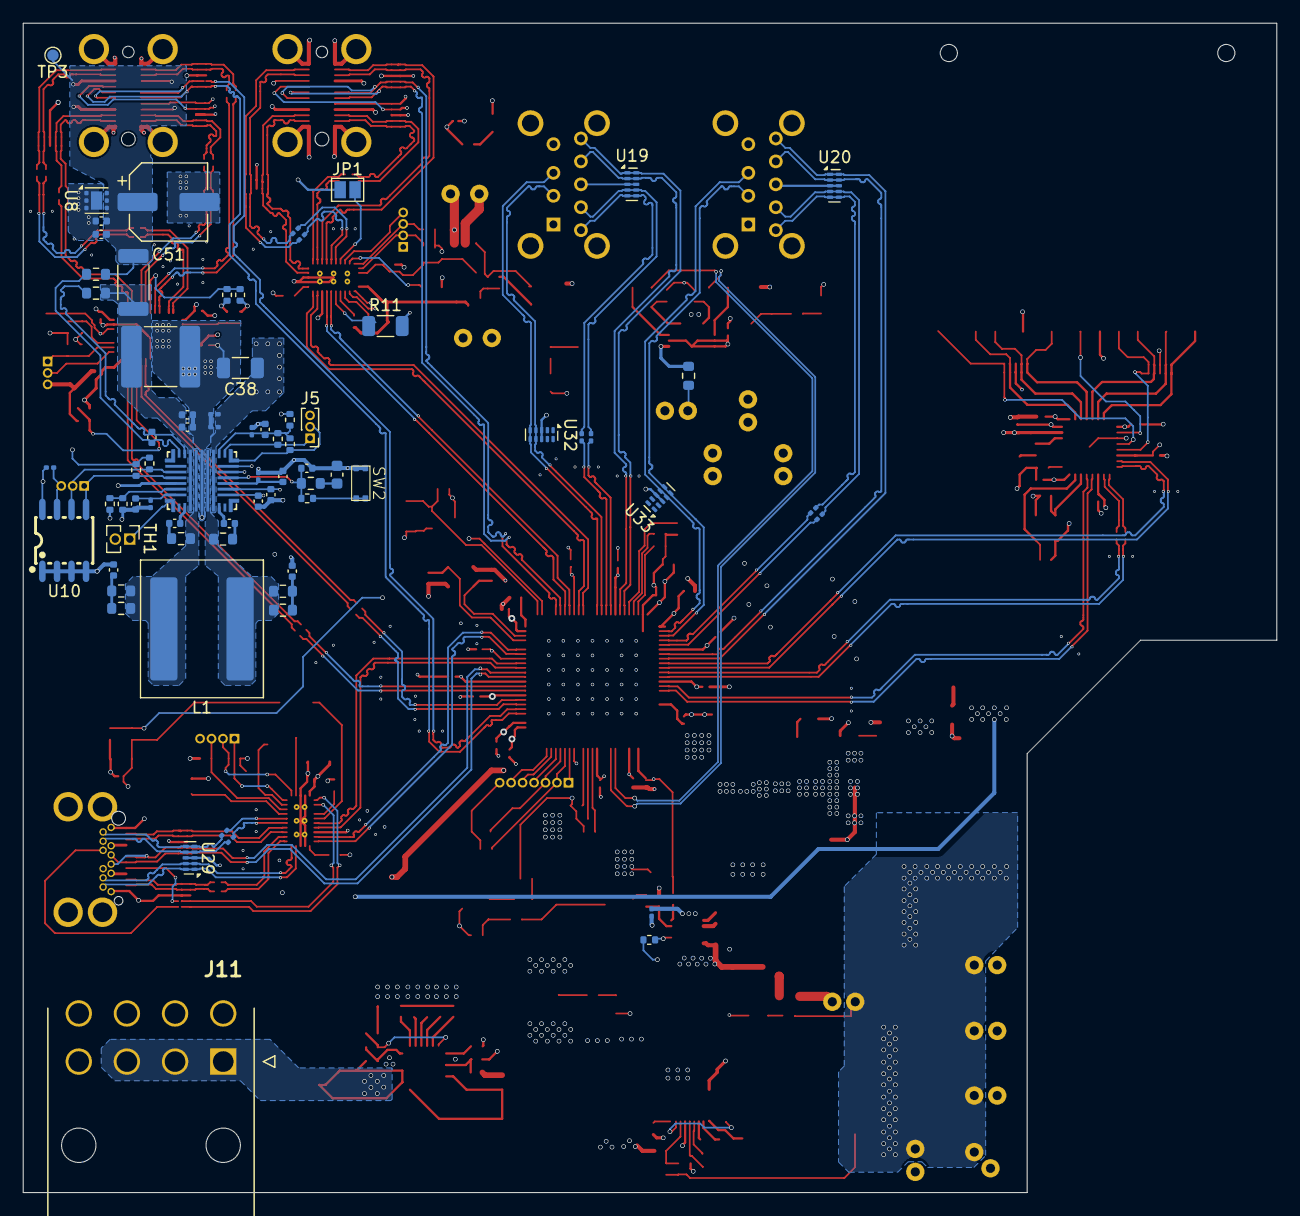
[picture p31: board USB_hub.kicad_pcb from below]

Board: 6 copper layers, 109.3 x 102.0 mm, 315 parts (72 on the bottom side), 244 nets.
